TaylorAndonian/cycloidal-drive/designs/02-cyc50-d100/analysis/load_sharing_design.png

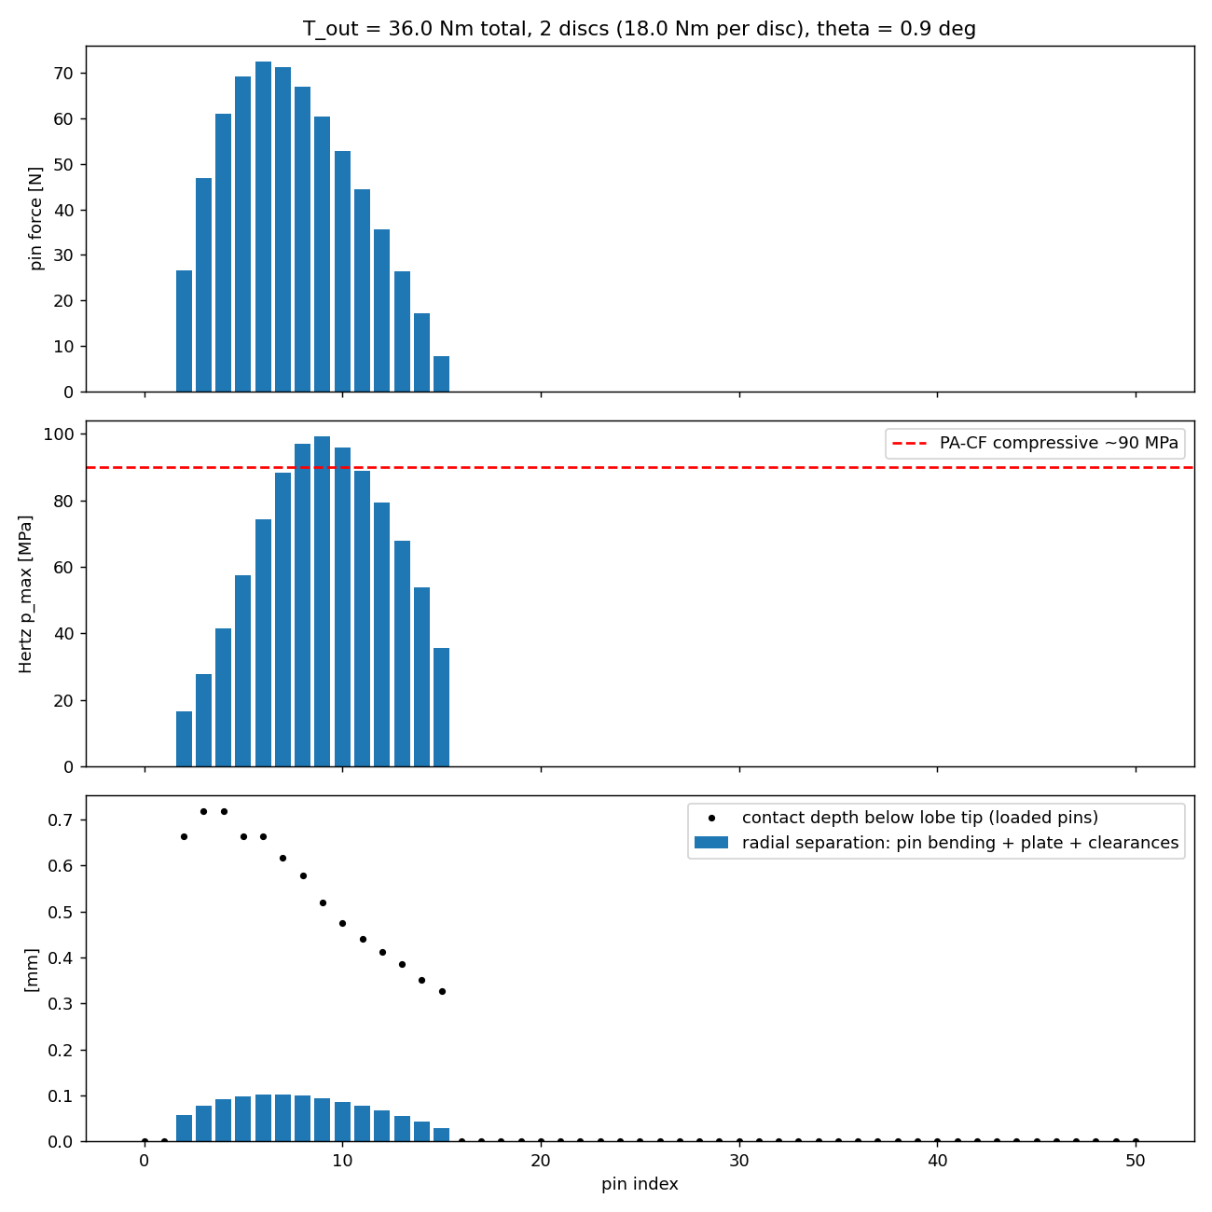
designs/02-cyc50-d100/analysis/load_sharing_design.png
