TaylorAndonian/cycloidal-drive/designs/02-cyc50-d100/analysis/margin_vs_torque.png

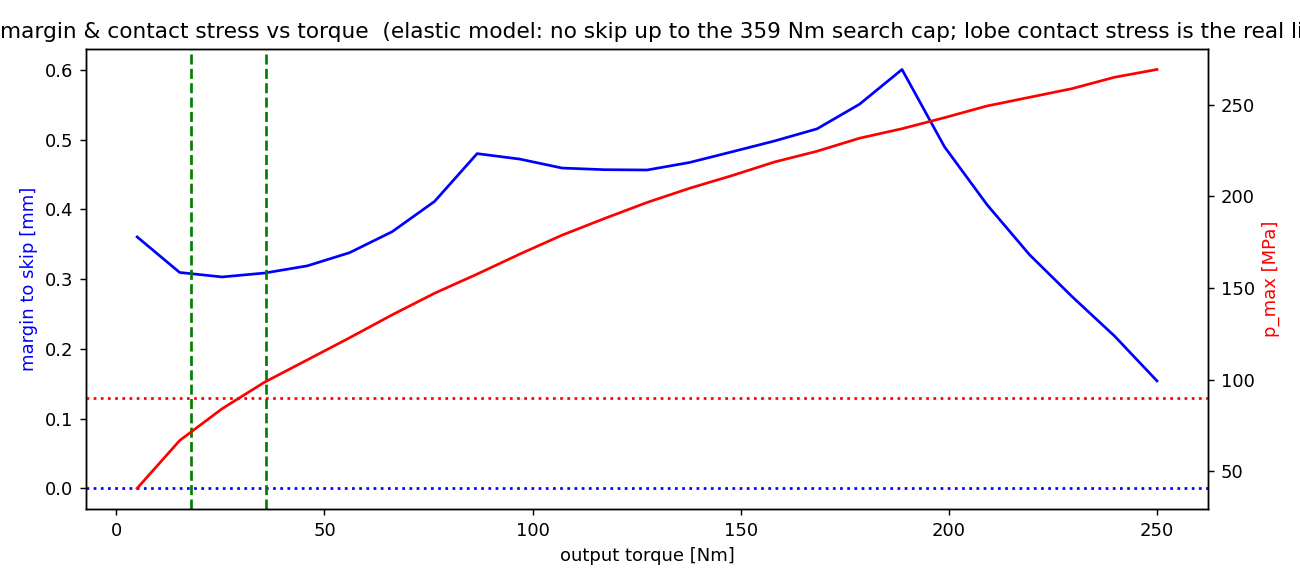
designs/02-cyc50-d100/analysis/margin_vs_torque.png
