TaylorAndonian/cycloidal-drive/designs/02-cyc50-d100/analysis/pressure_angle_pins.png

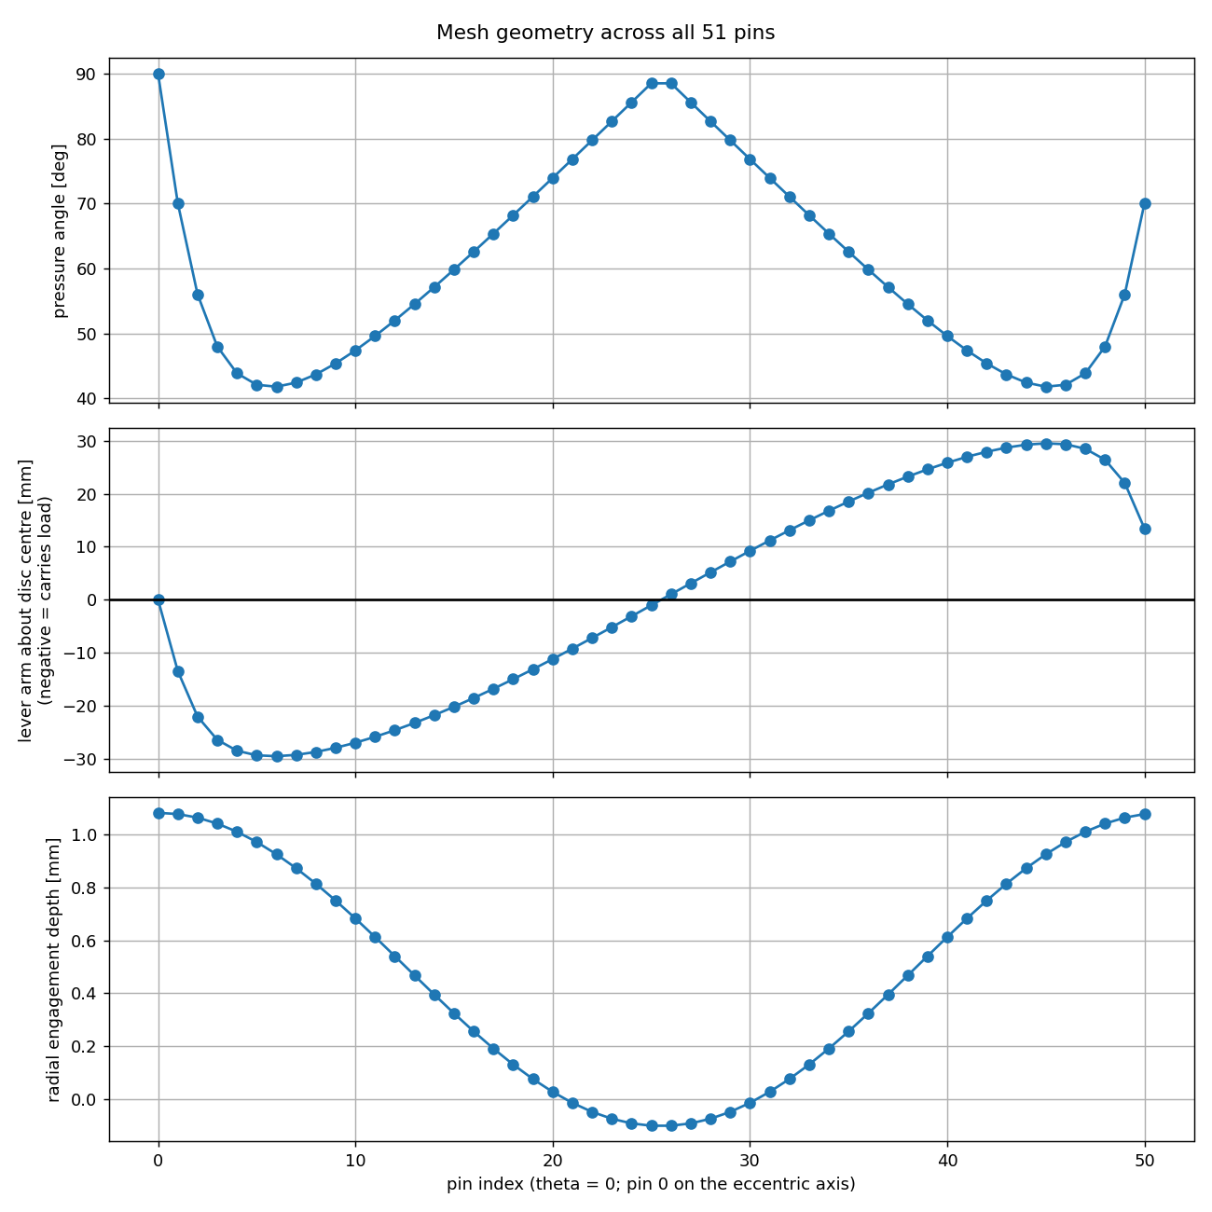
designs/02-cyc50-d100/analysis/pressure_angle_pins.png
