TaylorAndonian/cycloidal-drive/designs/02-cyc50-d100/analysis/profile.png

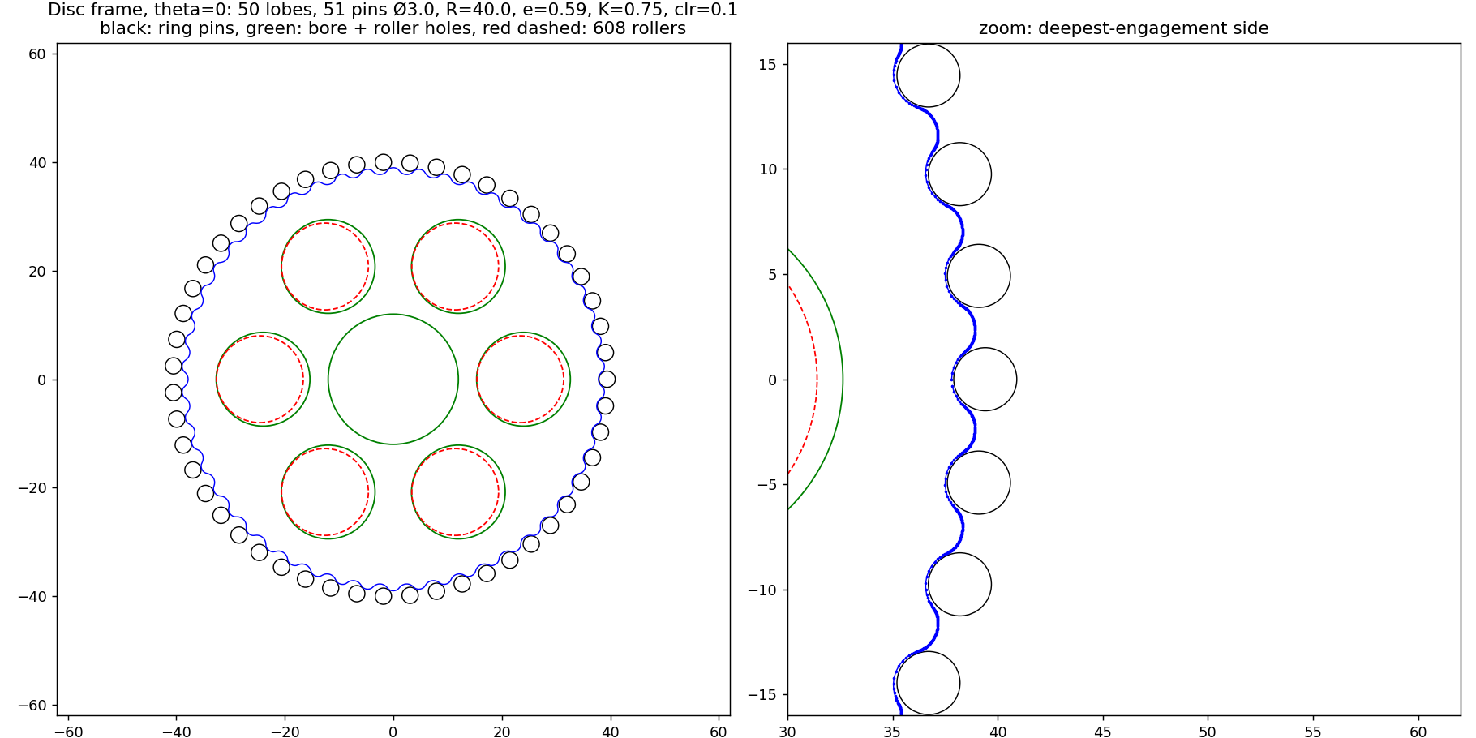
designs/02-cyc50-d100/analysis/profile.png
