TaylorAndonian/cycloidal-drive/designs/02-cyc50-d100/renders/axial_layout.png

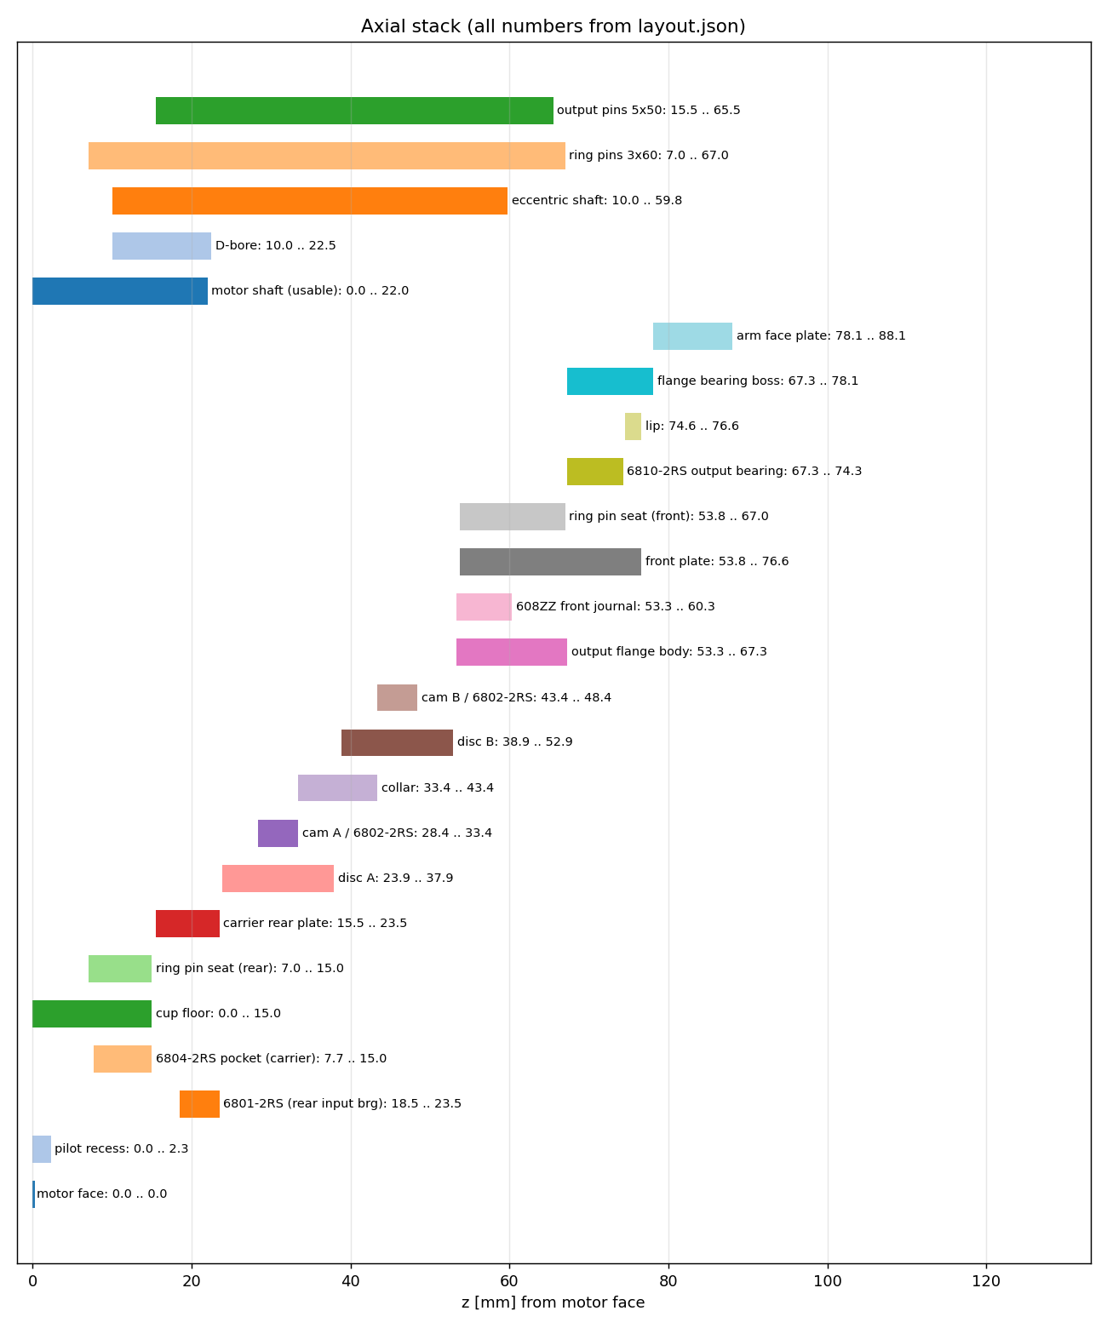
designs/02-cyc50-d100/renders/axial_layout.png
