TaylorAndonian/cycloidal-drive/designs/03-cyc30-d80-v1/preview.png

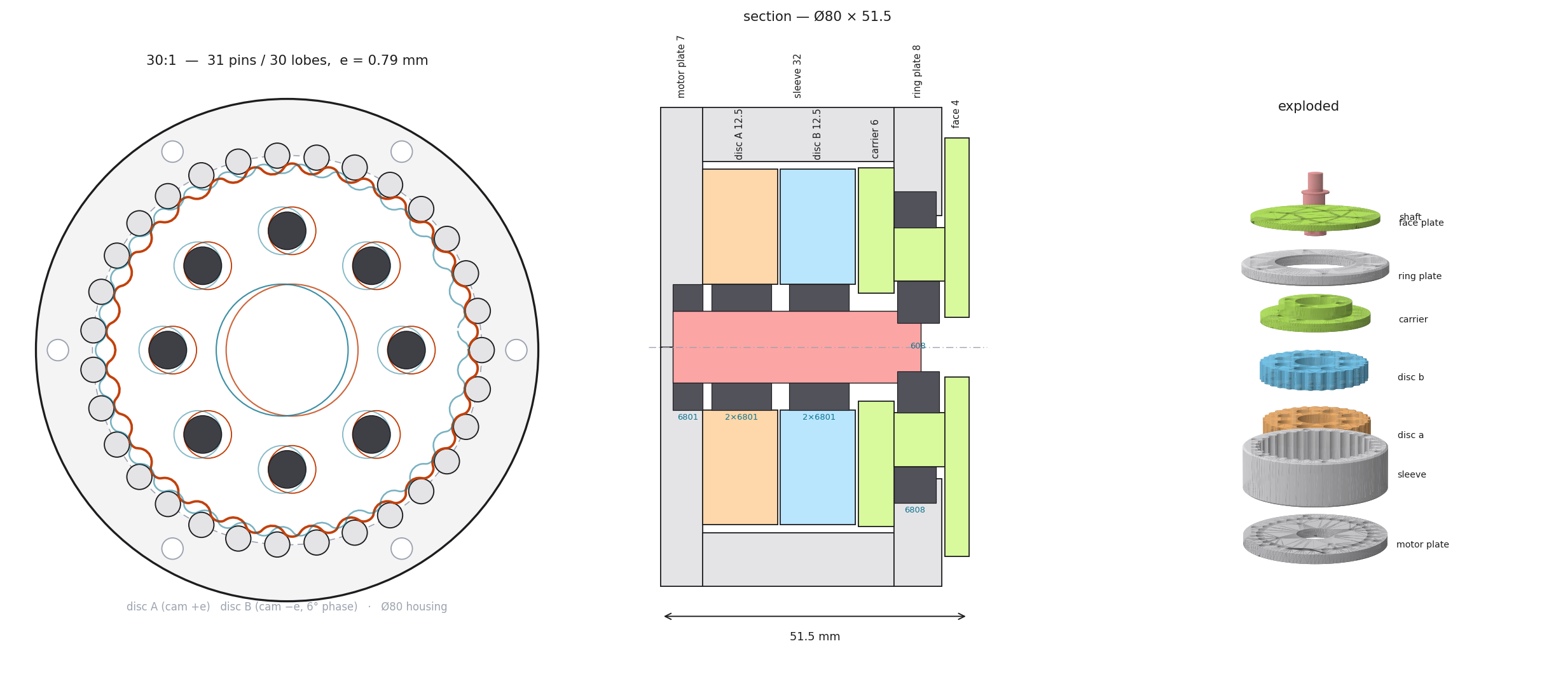
designs/03-cyc30-d80-v1/preview.png
