TaylorAndonian/cycloidal-drive/designs/06-cyc30-d80-belt/belt_iso.png

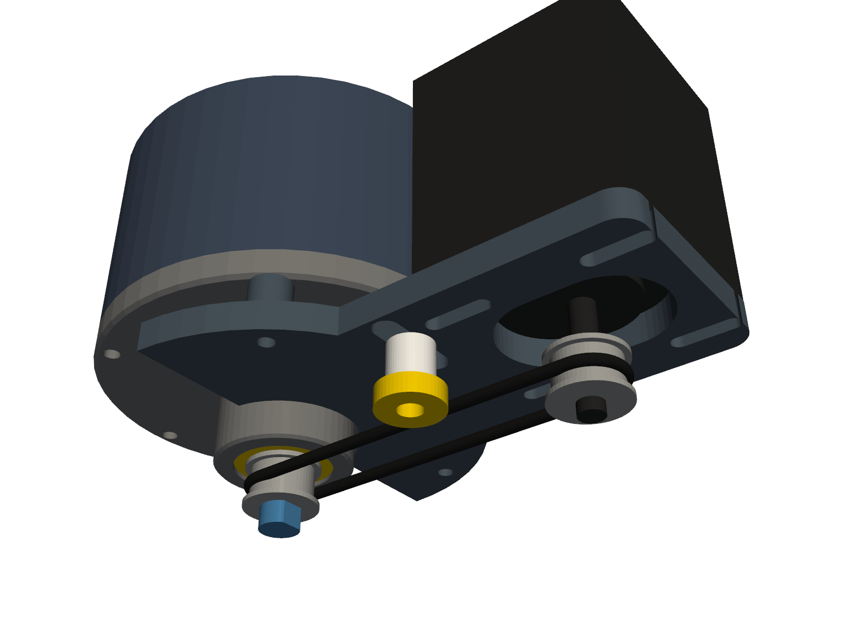
designs/06-cyc30-d80-belt/belt_iso.png
