TaylorAndonian/cycloidal-drive/designs/01-cyc50-d138/cad/assembly.step

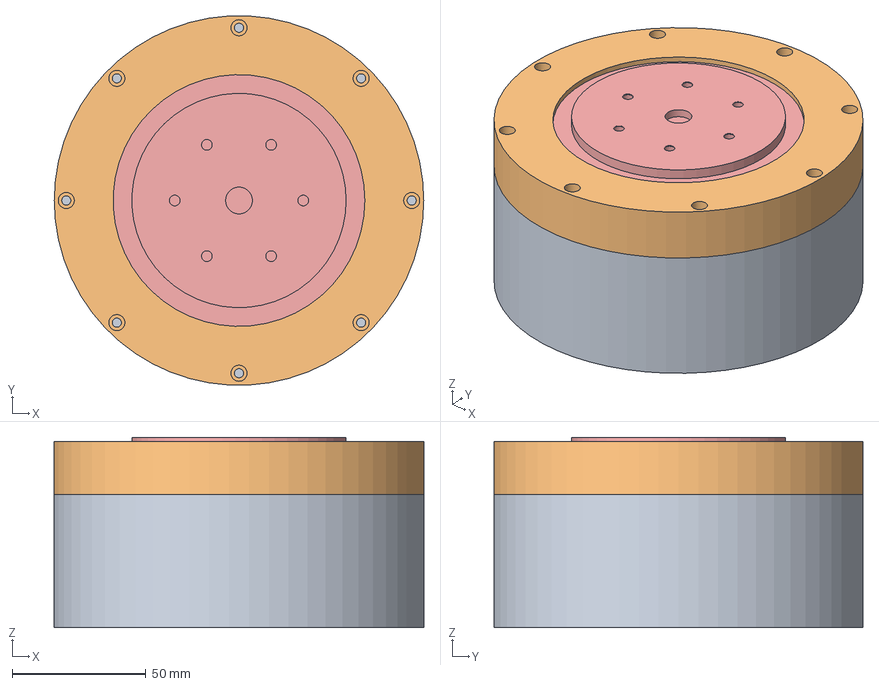
[picture p11: CAD file, 2026-09-05]
designs/01-cyc50-d138/cad/assembly.step
138.0 x 137.8 x 71.1 mm
