TaylorAndonian/cycloidal-drive/designs/03-cyc30-d80-v1/step/assembly.step

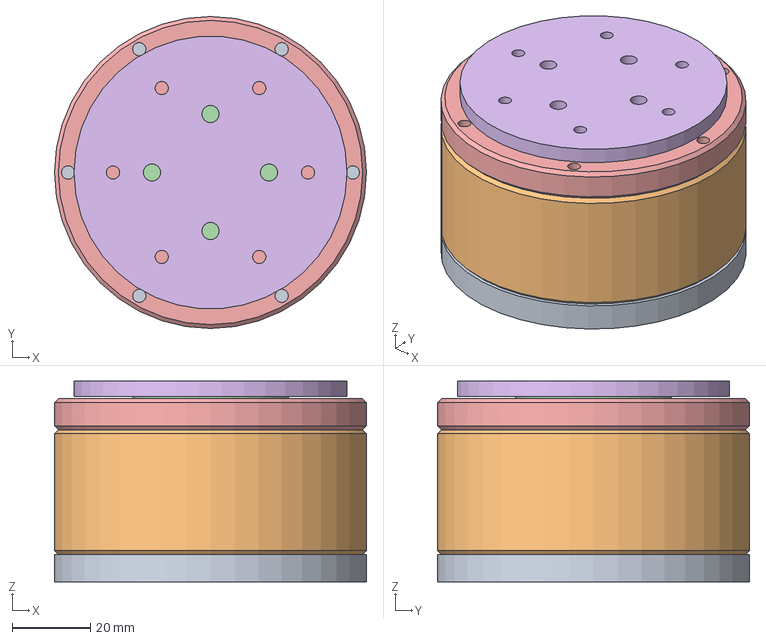
[picture p12: CAD file, 2026-09-16]
designs/03-cyc30-d80-v1/step/assembly.step
80.0 x 80.0 x 51.5 mm
