TaylorAndonian/cycloidal-drive/designs/06-cyc30-d80-belt/step/ASSEMBLY_belt_drive.step

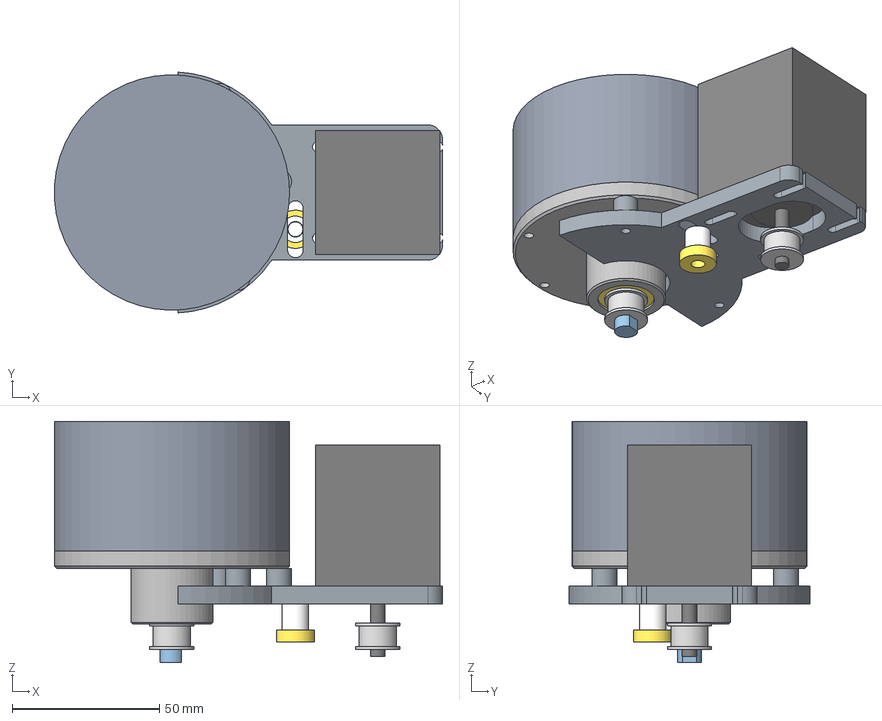
[picture p13: CAD file, 2026-10-05]
designs/06-cyc30-d80-belt/step/ASSEMBLY_belt_drive.step
131.9 x 81.9 x 82.0 mm
back_plate_belt
input_shaft
motor_bracket
idler_standoff
tower_bearing_spacer
608_rear_1
608_rear_2
pulley_20T_shaft
pulley_20T_motor
idler_F695
housing_reference
NEMA17
