TaylorAndonian/cycloidal-drive/designs/04-cyc30-d80-v2/step/ASSEMBLY_cycloidal_30_d80_v2.step

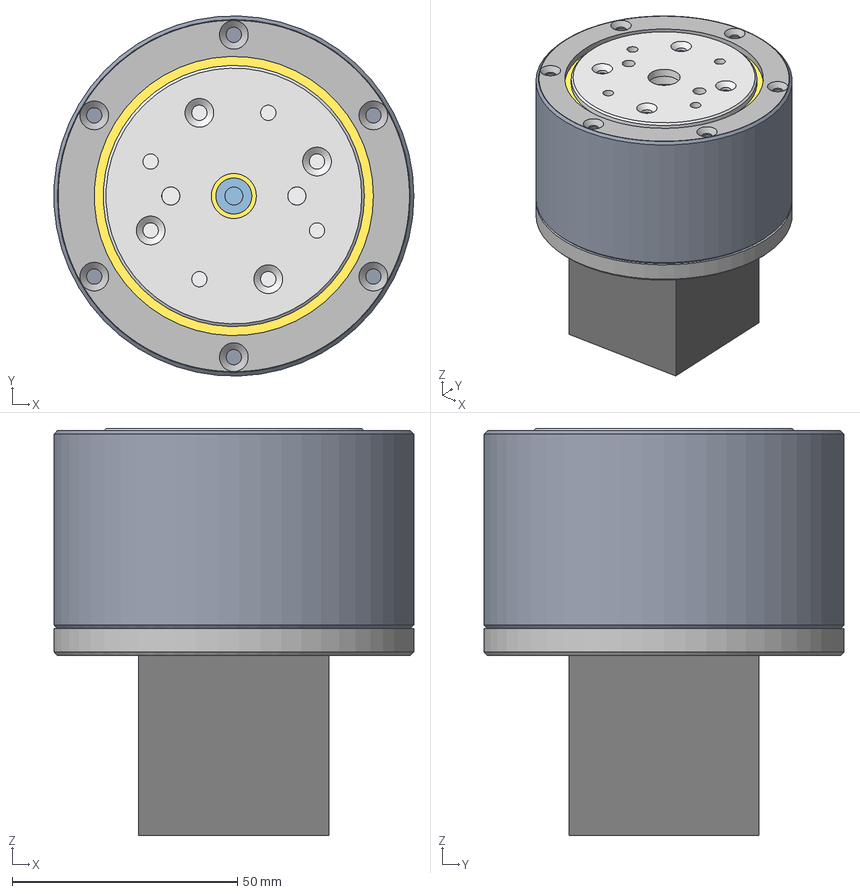
[picture p14: CAD file, 2026-09-22]
designs/04-cyc30-d80-v2/step/ASSEMBLY_cycloidal_30_d80_v2.step
79.9 x 80.0 x 90.5 mm
back_plate
housing
front_retainer
disc_2 (rotated 90deg) x 2
cam_B x 2
input_shaft
shaft_spacer
rear_ring
output_flange
output_cap
ring_pin_0
ring_pin_1
ring_pin_2
ring_pin_3
ring_pin_4
ring_pin_5
ring_pin_6
ring_pin_7
ring_pin_8
ring_pin_9
ring_pin_10
ring_pin_11
ring_pin_12
ring_pin_13
ring_pin_14
ring_pin_15
ring_pin_16
ring_pin_17
ring_pin_18
ring_pin_19
ring_pin_20
ring_pin_21
ring_pin_22
ring_pin_23
ring_pin_24
ring_pin_25
ring_pin_26
ring_pin_27
ring_pin_28
ring_pin_29
ring_pin_30
shoulder_bolt_0
MR105_0 x 2
sleeve x 24
shoulder_bolt_1
MR105_1 x 2
shoulder_bolt_2
MR105_2 x 2
shoulder_bolt_3
MR105_3 x 2
shoulder_bolt_4
MR105_4 x 2
shoulder_bolt_5
MR105_5 x 2
shoulder_bolt_6
MR105_6 x 2
shoulder_bolt_7
MR105_7 x 2
6803_disc1 x 2
6803_disc2 x 2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
