TaylorAndonian/cycloidal-drive/designs/02-cyc50-d100/cad/assembly.step

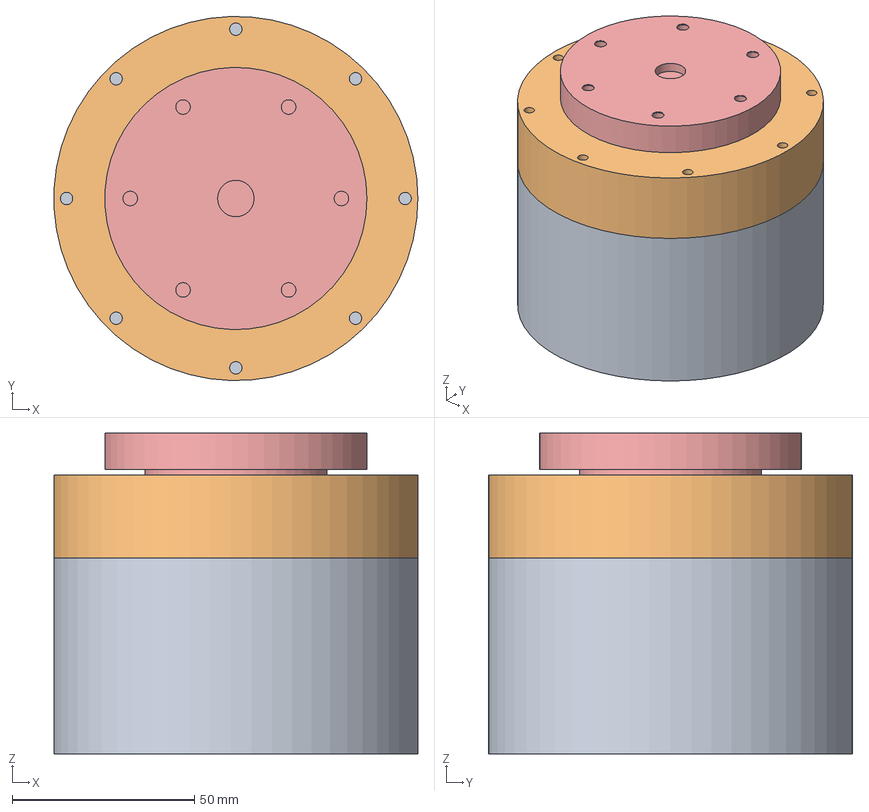
[picture p15: CAD file, 2026-09-05]
designs/02-cyc50-d100/cad/assembly.step
99.9 x 100.0 x 88.1 mm
