TaylorAndonian/cycloidal-drive/designs/02-cyc50-d100/cad/eccentric_shaft.step

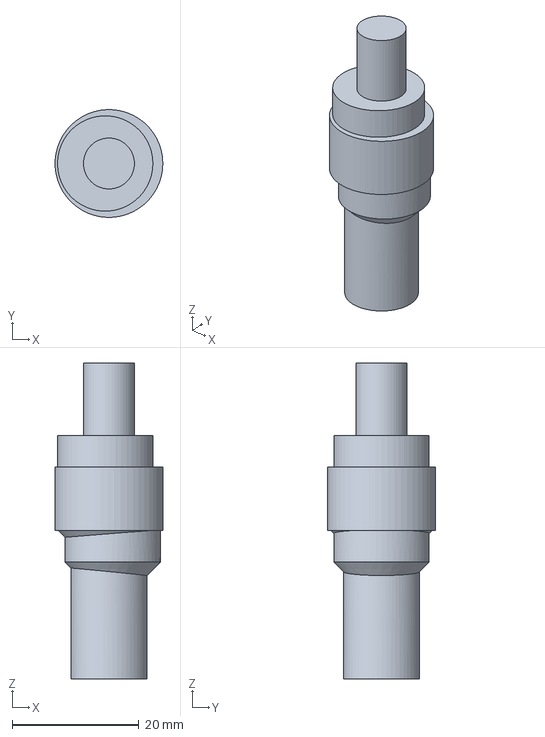
[picture p16: CAD file, 2026-09-10]
designs/02-cyc50-d100/cad/eccentric_shaft.step
17.0 x 17.0 x 49.8 mm
