TaylorAndonian/cycloidal-drive/designs/03-cyc30-d80-v1/step/disc_b.step

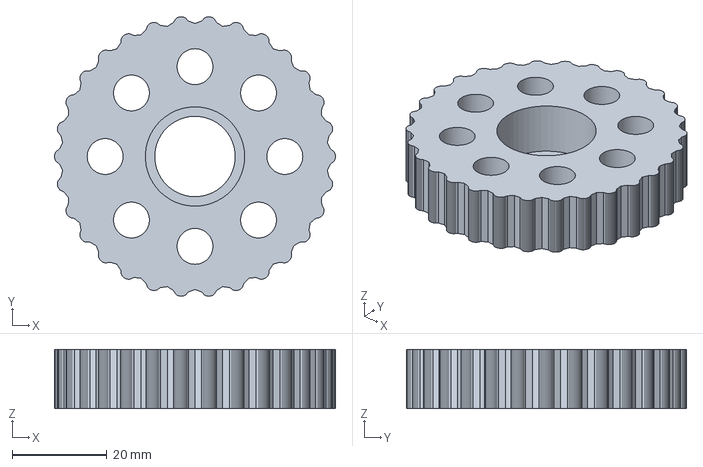
[picture p17: CAD file, 2026-09-16]
designs/03-cyc30-d80-v1/step/disc_b.step
59.4 x 59.1 x 12.5 mm
