TaylorAndonian/cycloidal-drive/designs/04-cyc30-d80-v2/step/back_plate.step

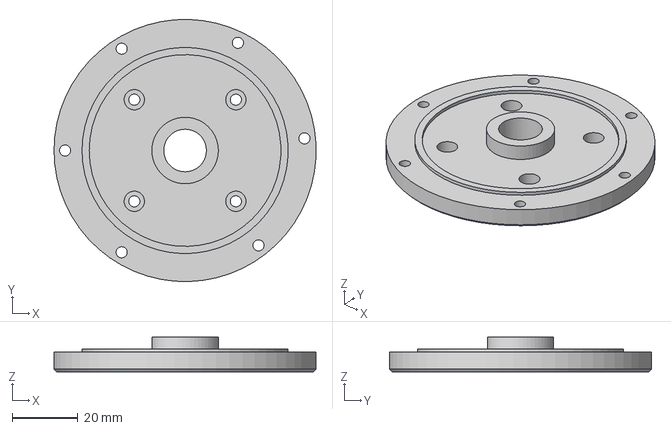
[picture p18: CAD file, 2026-09-30]
designs/04-cyc30-d80-v2/step/back_plate.step
79.9 x 80.0 x 10.6 mm
