TaylorAndonian/cycloidal-drive/designs/05-cyc30-d80-v3/step/housing.step

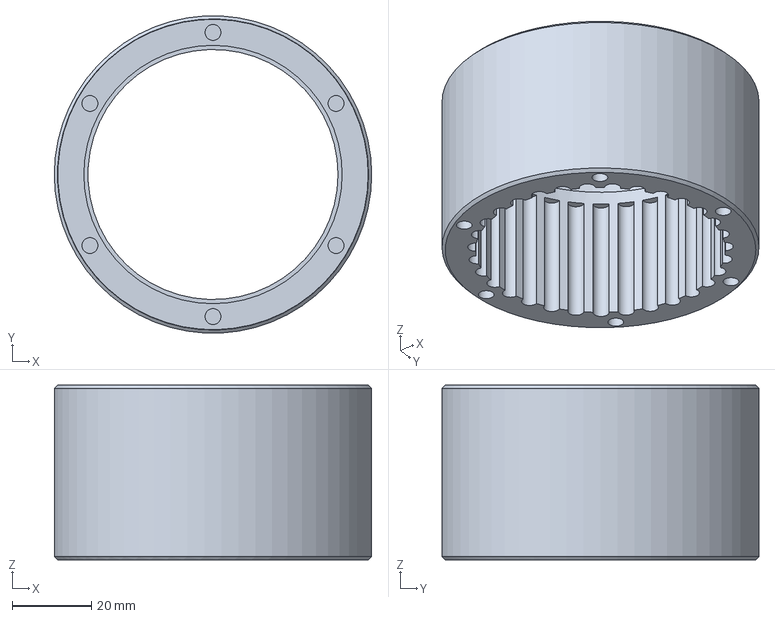
[picture p19: CAD file, 2026-10-02]
designs/05-cyc30-d80-v3/step/housing.step
80.0 x 79.9 x 44.0 mm
