TaylorAndonian/cycloidal-drive/designs/06-cyc30-d80-belt/step/back_plate_belt.step

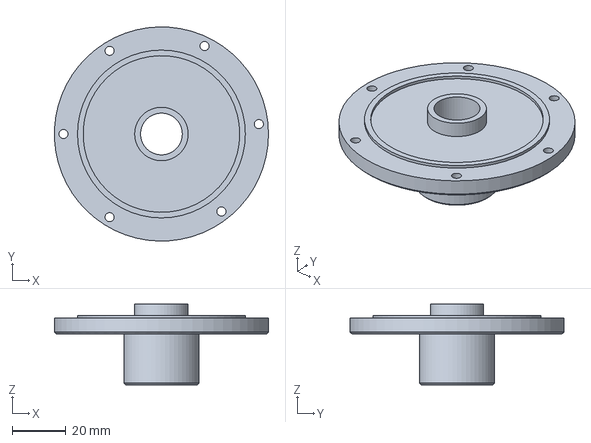
[picture p20: CAD file, 2026-10-05]
designs/06-cyc30-d80-belt/step/back_plate_belt.step
79.9 x 80.0 x 30.1 mm
