TaylorAndonian/cycloidal-drive/designs/02-cyc50-d100/cad/coupon_shaft.step

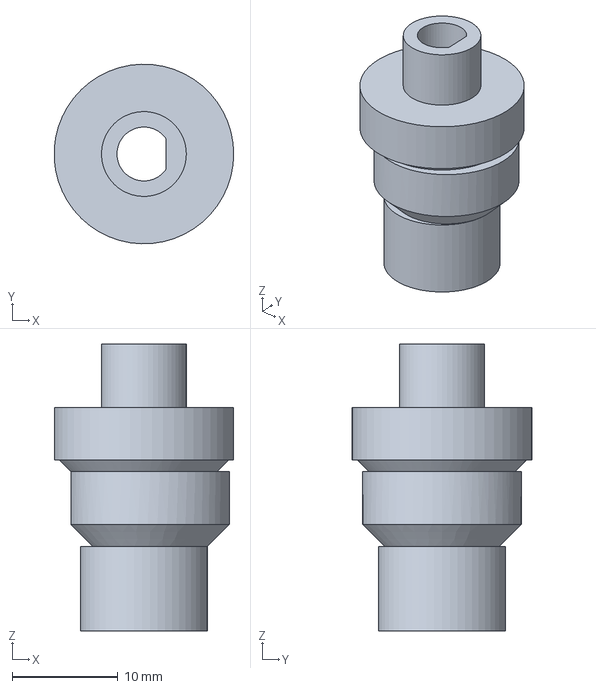
[picture p21: CAD file, 2026-09-10]
designs/02-cyc50-d100/cad/coupon_shaft.step
17.0 x 17.0 x 27.2 mm
