TaylorAndonian/cycloidal-drive/designs/03-cyc30-d80-v1/step/ring_plate.step

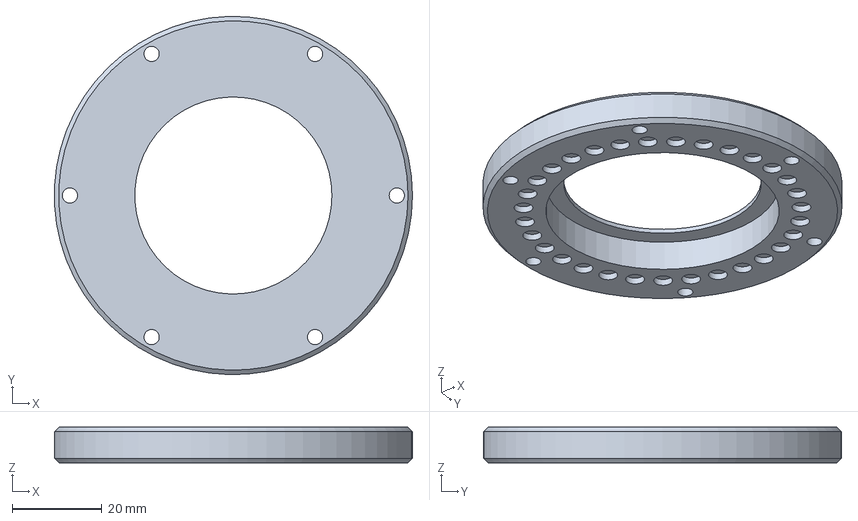
[picture p22: CAD file, 2026-09-16]
designs/03-cyc30-d80-v1/step/ring_plate.step
79.9 x 80.0 x 8.00 mm
