TaylorAndonian/cycloidal-drive/designs/04-cyc30-d80-v2/step/cam.step

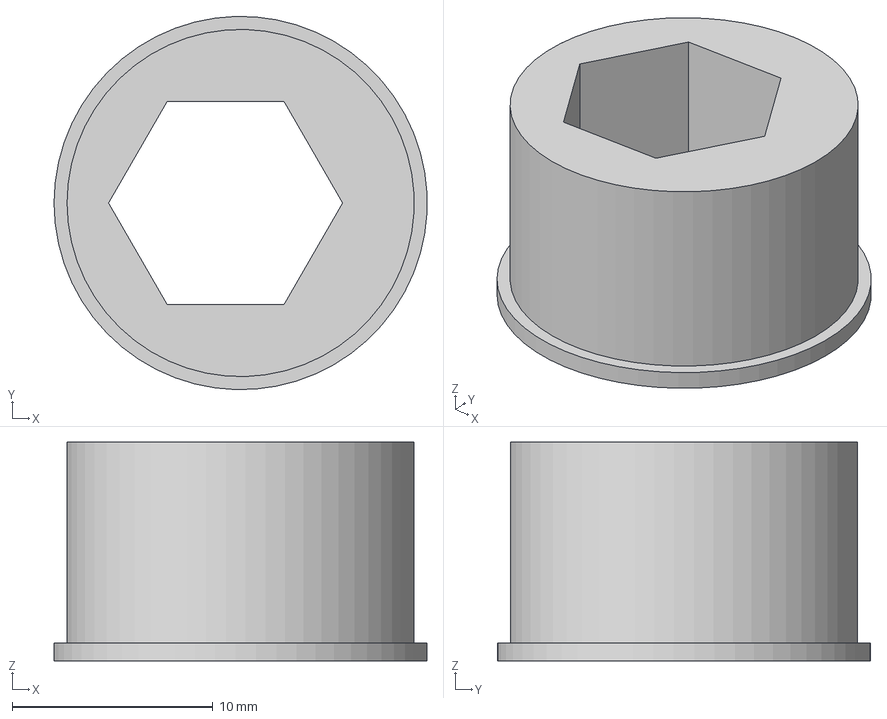
[picture p23: CAD file, 2026-09-29]
designs/04-cyc30-d80-v2/step/cam.step
18.6 x 18.6 x 10.9 mm
