TaylorAndonian/cycloidal-drive/designs/05-cyc30-d80-v3/step/fit_coupon.step

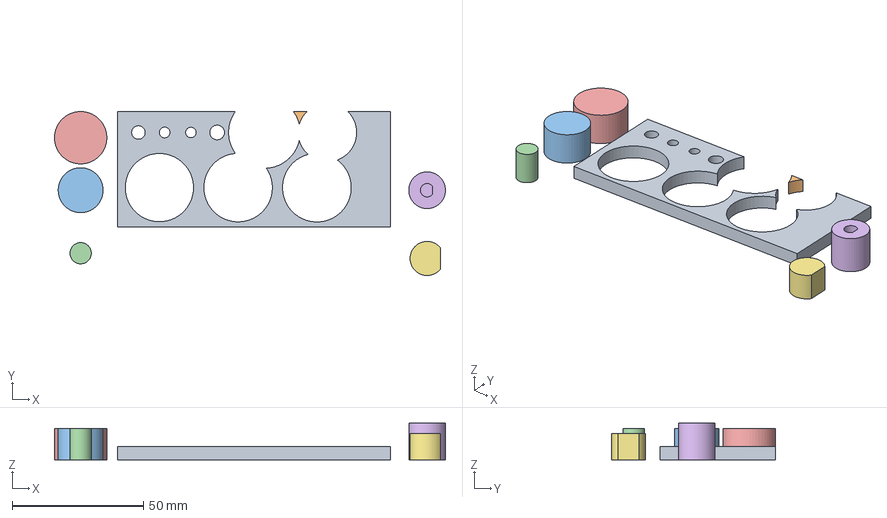
[picture p24: CAD file, 2026-10-02]
designs/05-cyc30-d80-v3/step/fit_coupon.step
149.0 x 62.5 x 14.0 mm
