TaylorAndonian/cycloidal-drive/designs/06-cyc30-d80-belt/step/idler_standoff.step

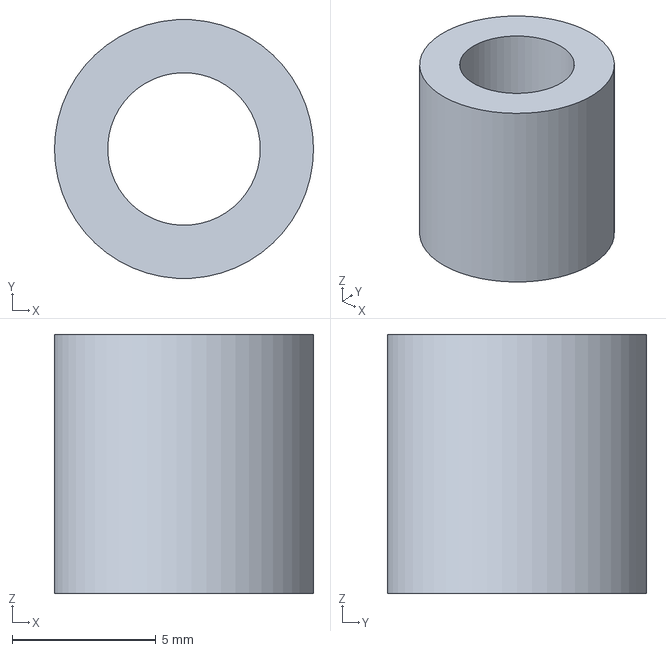
[picture p25: CAD file, 2026-10-05]
designs/06-cyc30-d80-belt/step/idler_standoff.step
9.00 x 8.98 x 9.00 mm
