TaylorAndonian/cycloidal-drive/designs/02-cyc50-d100/cad/disc v1.step

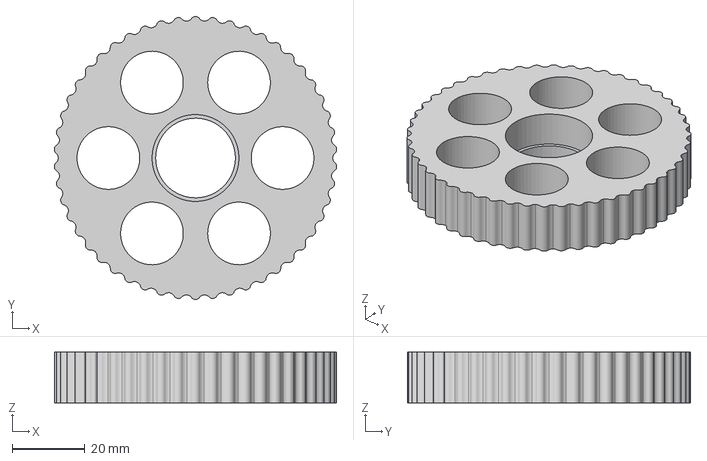
[picture p26: CAD file, 2026-09-08]
designs/02-cyc50-d100/cad/disc v1.step
77.8 x 78.0 x 14.0 mm
