TaylorAndonian/cycloidal-drive/designs/04-cyc30-d80-v2/step/input_shaft.step

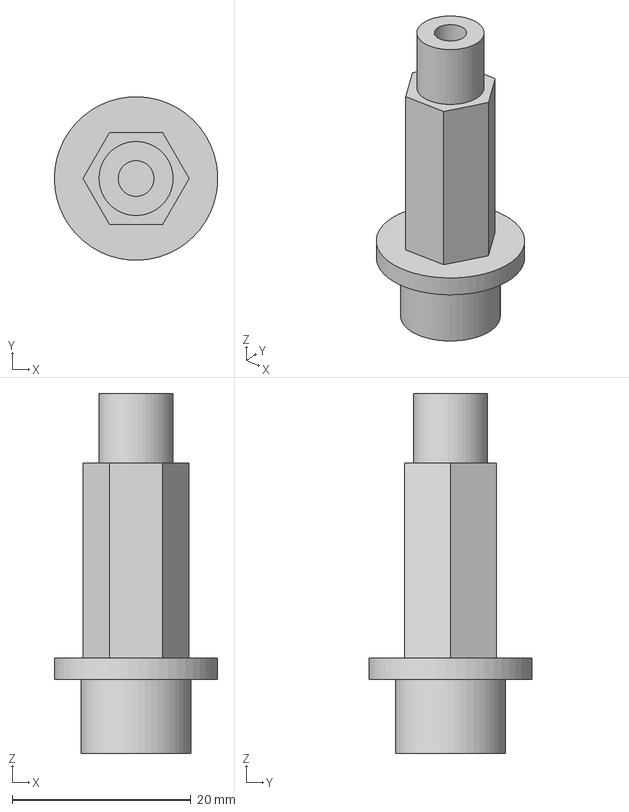
[picture p27: CAD file, 2026-09-26]
designs/04-cyc30-d80-v2/step/input_shaft.step
18.3 x 18.3 x 40.3 mm
