TaylorAndonian/cycloidal-drive/designs/05-cyc30-d80-v3/step/rear_ring.step

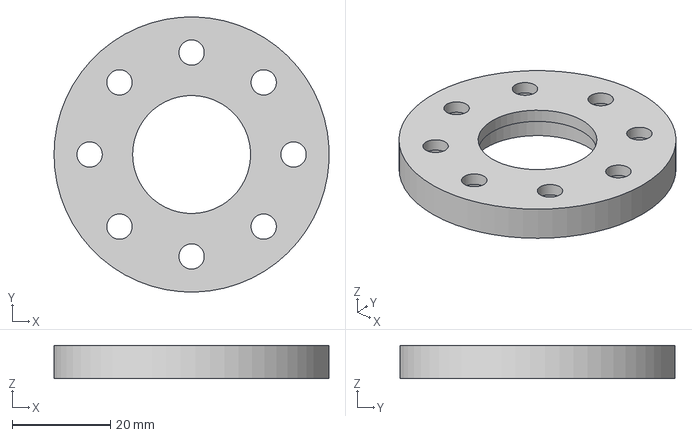
[picture p28: CAD file, 2026-10-02]
designs/05-cyc30-d80-v3/step/rear_ring.step
56.0 x 56.0 x 6.80 mm
