TaylorAndonian/cycloidal-drive/designs/02-cyc50-d100/cad/mid_pin_ring.step

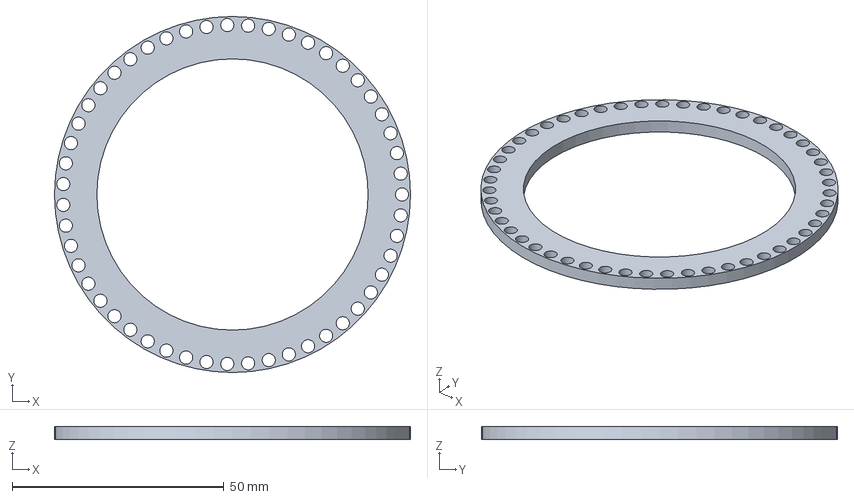
[picture p29: CAD file, 2026-09-05]
designs/02-cyc50-d100/cad/mid_pin_ring.step
84.0 x 84.0 x 3.00 mm
