TaylorAndonian/cycloidal-drive/designs/03-cyc30-d80-v1/step/shaft.step

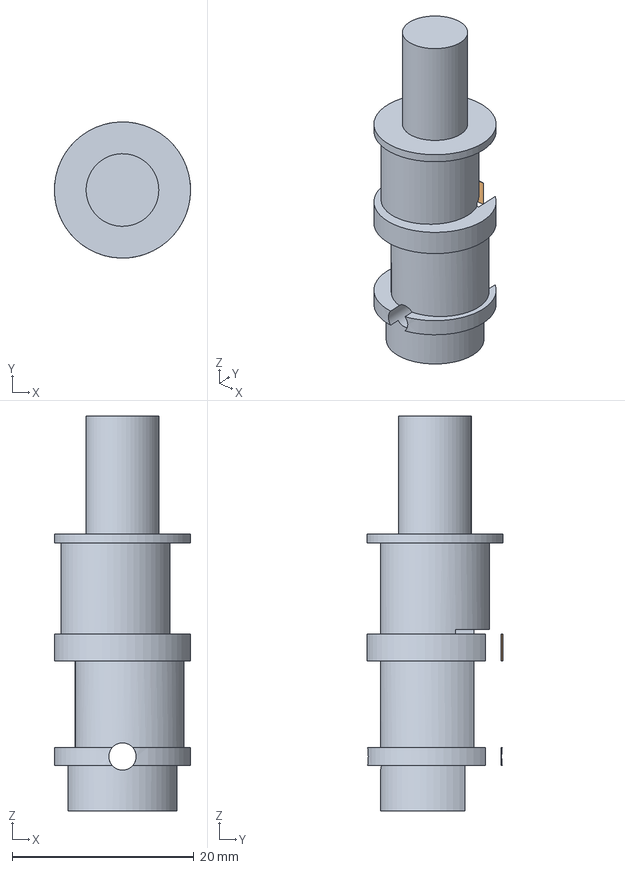
[picture p30: CAD file, 2026-09-16]
designs/03-cyc30-d80-v1/step/shaft.step
15.0 x 15.0 x 43.5 mm
