TaylorAndonian/cycloidal-drive/designs/04-cyc30-d80-v2/step/C DISK.step

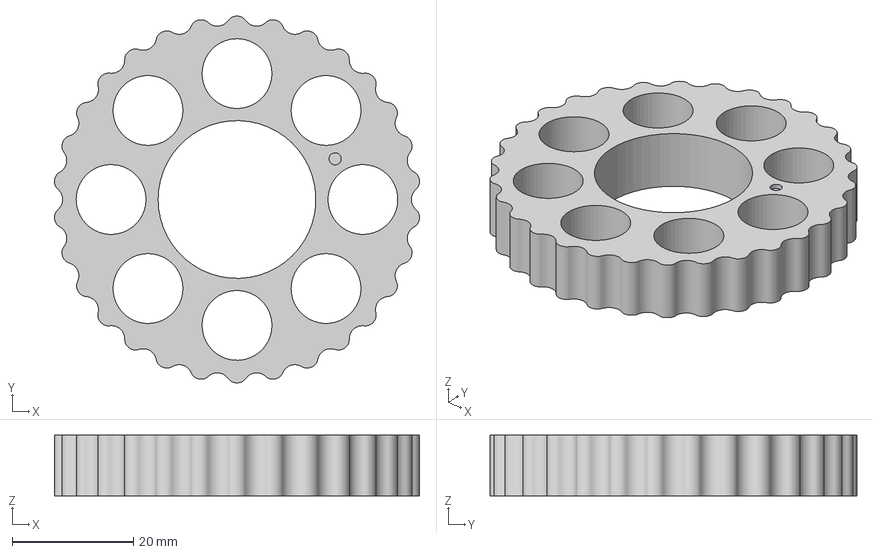
[picture p31: CAD file, 2026-09-23]
designs/04-cyc30-d80-v2/step/C DISK.step
60.1 x 60.5 x 10.0 mm
