TaylorAndonian/cycloidal-drive/designs/05-cyc30-d80-v3/step/output_flange.step

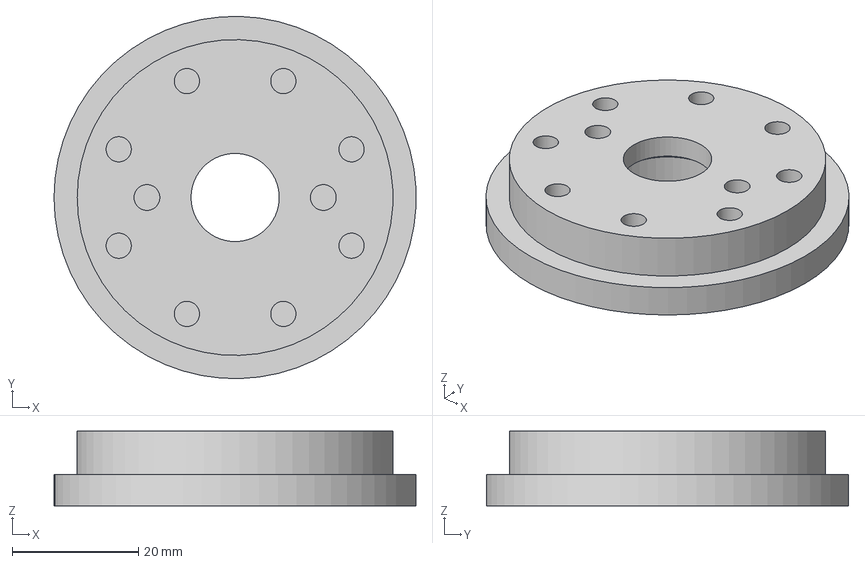
[picture p32: CAD file, 2026-10-02]
designs/05-cyc30-d80-v3/step/output_flange.step
57.5 x 57.5 x 11.9 mm
