TaylorAndonian/cycloidal-drive/designs/06-cyc30-d80-belt/step/tower_bearing_spacer.step

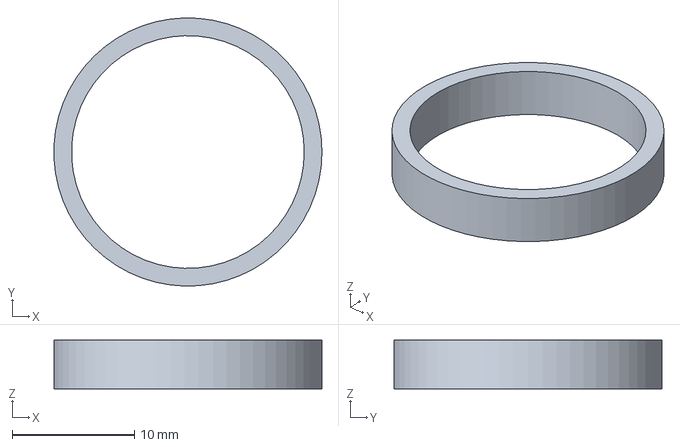
[picture p33: CAD file, 2026-10-05]
designs/06-cyc30-d80-belt/step/tower_bearing_spacer.step
21.9 x 21.9 x 4.00 mm
