TaylorAndonian/cycloidal-drive/designs/02-cyc50-d100/cad/front_plate.step

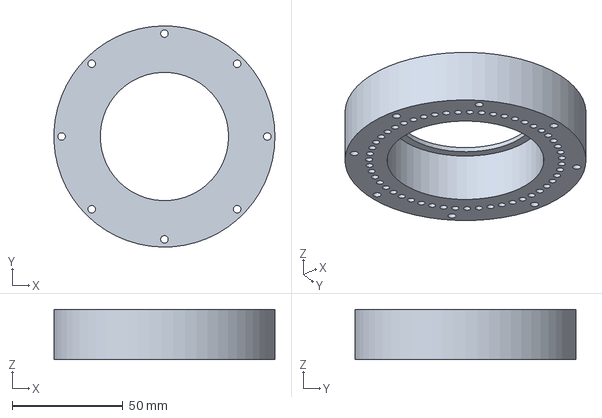
[picture p34: CAD file, 2026-09-05]
designs/02-cyc50-d100/cad/front_plate.step
99.9 x 100.0 x 22.8 mm
