TaylorAndonian/cycloidal-drive/designs/03-cyc30-d80-v1/step/coupon.step

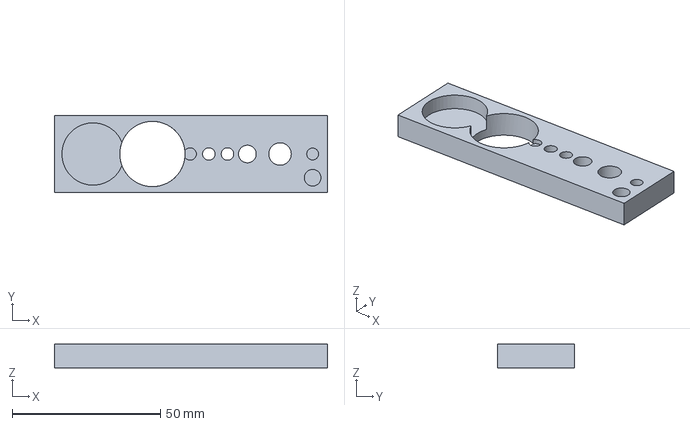
[picture p35: CAD file, 2026-09-16]
designs/03-cyc30-d80-v1/step/coupon.step
92.0 x 26.0 x 8.00 mm
