TaylorAndonian/cycloidal-drive/designs/05-cyc30-d80-v3/step/roller_sleeve_3.6.step

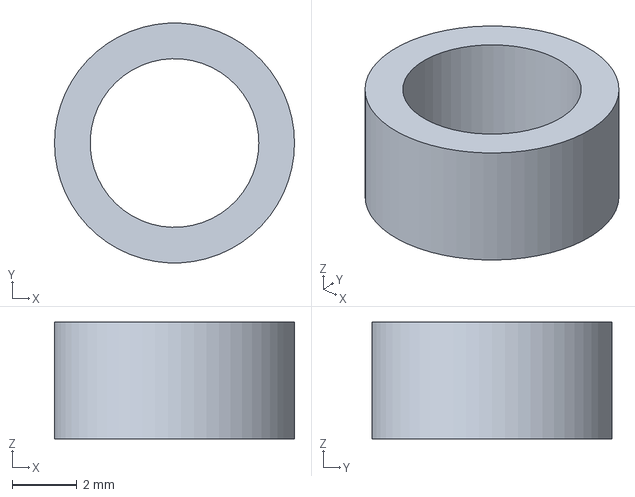
[picture p36: CAD file, 2026-10-01]
designs/05-cyc30-d80-v3/step/roller_sleeve_3.6.step
7.40 x 7.39 x 3.60 mm
