TaylorAndonian/cycloidal-drive/designs/06-cyc30-d80-belt/step/motor_bracket.step

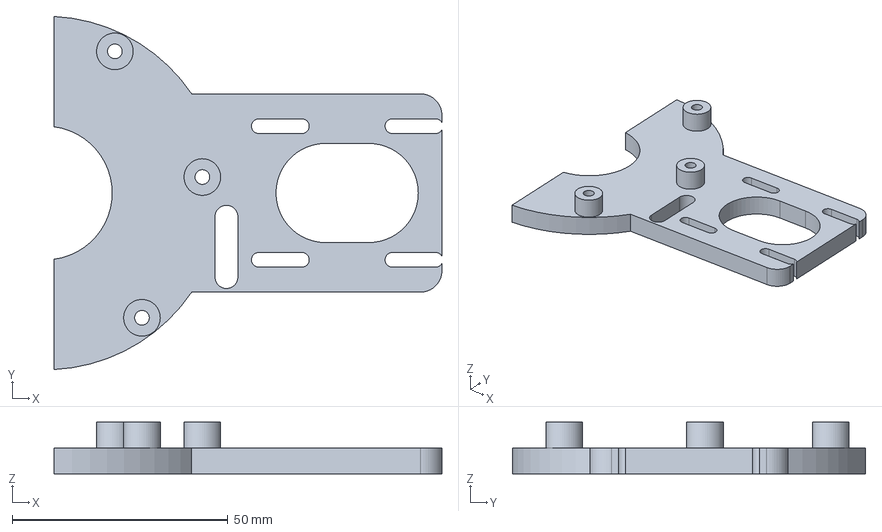
[picture p37: CAD file, 2026-10-05]
designs/06-cyc30-d80-belt/step/motor_bracket.step
90.0 x 81.9 x 12.0 mm
