TaylorAndonian/cycloidal-drive/designs/03-cyc30-d80-v1/step/sleeve.step

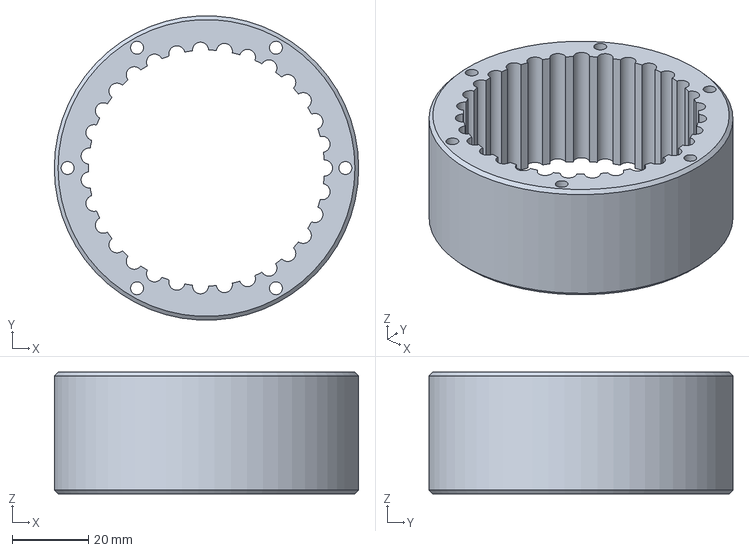
[picture p38: CAD file, 2026-09-16]
designs/03-cyc30-d80-v1/step/sleeve.step
80.0 x 79.9 x 32.0 mm
