TaylorAndonian/cycloidal-drive/designs/04-cyc30-d80-v2/step/roller_sleeve_6p9.step

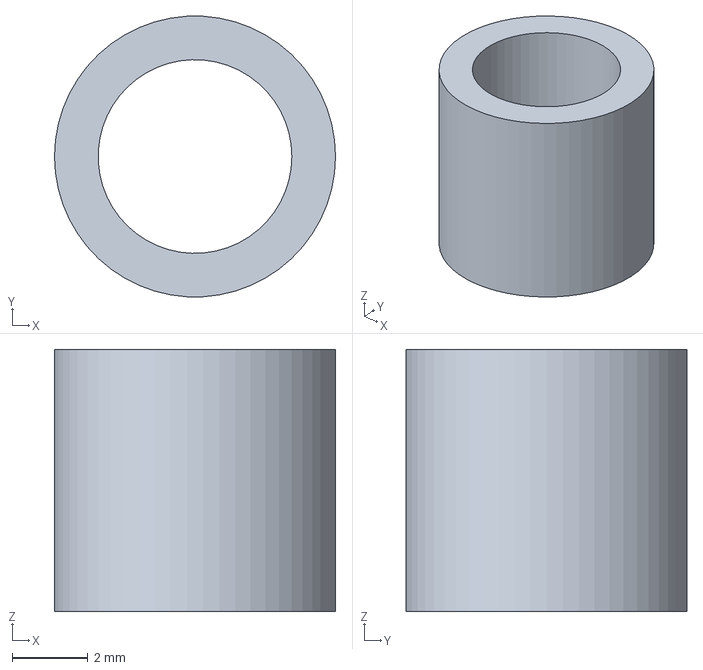
[picture p39: CAD file, 2026-09-22]
designs/04-cyc30-d80-v2/step/roller_sleeve_6p9.step
7.40 x 7.39 x 6.90 mm
