TaylorAndonian/cycloidal-drive/designs/05-cyc30-d80-v3/step/input_shaft.step

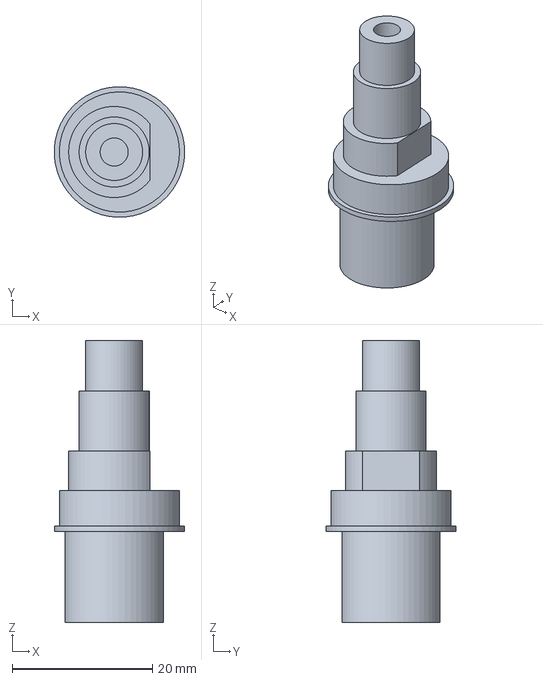
[picture p40: CAD file, 2026-10-01]
designs/05-cyc30-d80-v3/step/input_shaft.step
18.6 x 18.6 x 40.2 mm
