TaylorAndonian/cycloidal-drive/designs/06-cyc30-d80-belt/step/input_shaft_belt.step

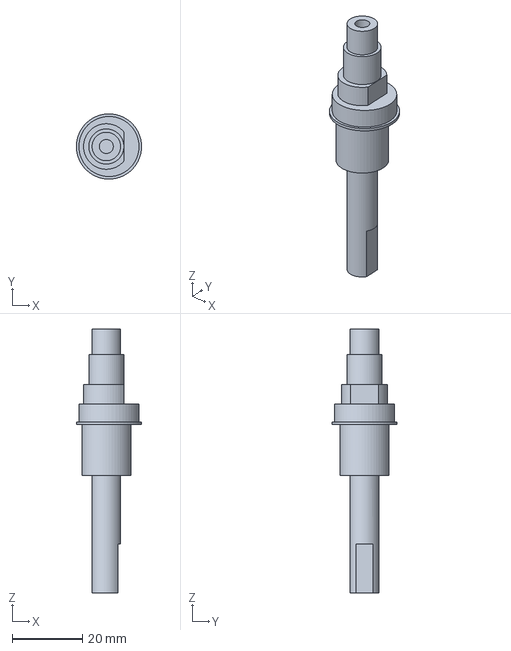
[picture p41: CAD file, 2026-10-05]
designs/06-cyc30-d80-belt/step/input_shaft_belt.step
18.6 x 18.6 x 75.2 mm
