TaylorAndonian/cycloidal-drive/designs/02-cyc50-d100/cad/coupon_bearings.step

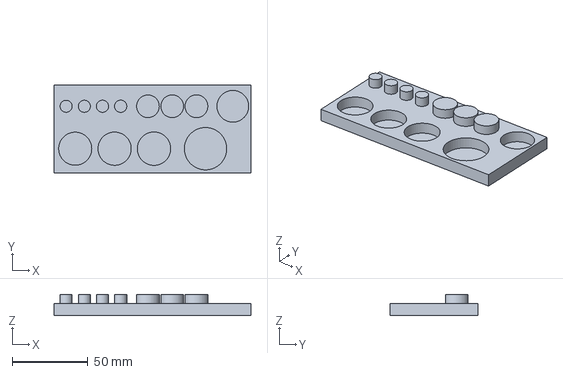
[picture p42: CAD file, 2026-09-05]
designs/02-cyc50-d100/cad/coupon_bearings.step
130.0 x 58.0 x 14.0 mm
