TaylorAndonian/cycloidal-drive/designs/03-cyc30-d80-v1/step/face_plate.step

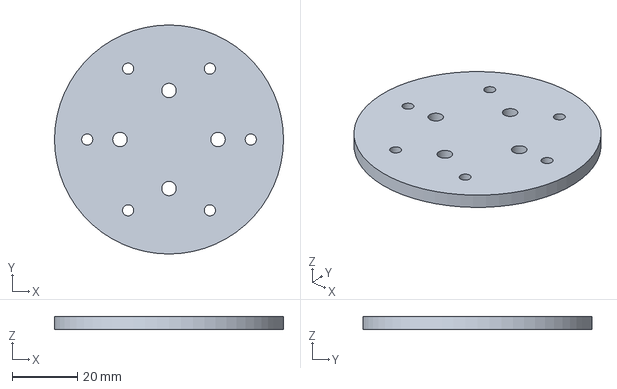
[picture p43: CAD file, 2026-09-16]
designs/03-cyc30-d80-v1/step/face_plate.step
70.0 x 70.0 x 4.00 mm
