TaylorAndonian/cycloidal-drive/designs/04-cyc30-d80-v2/step/roller_sleeve_3p9.step

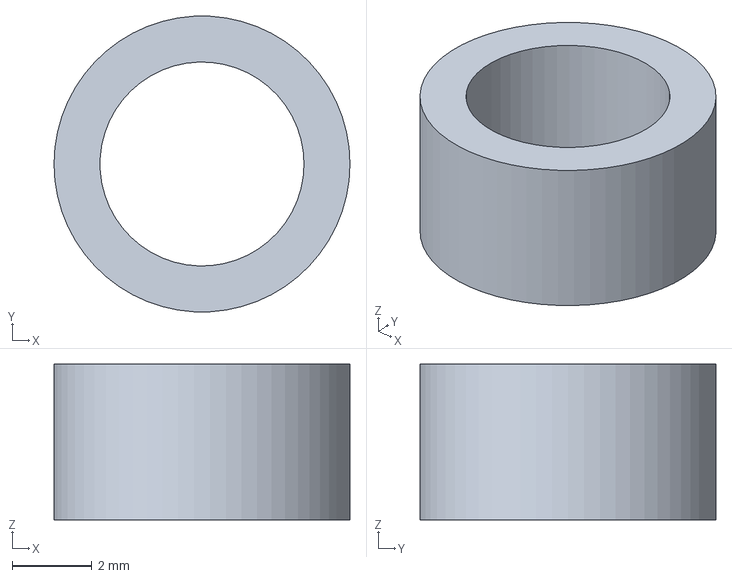
[picture p44: CAD file, 2026-09-22]
designs/04-cyc30-d80-v2/step/roller_sleeve_3p9.step
7.40 x 7.39 x 3.90 mm
