TaylorAndonian/cycloidal-drive/designs/05-cyc30-d80-v3/step/shaft_spacer.step

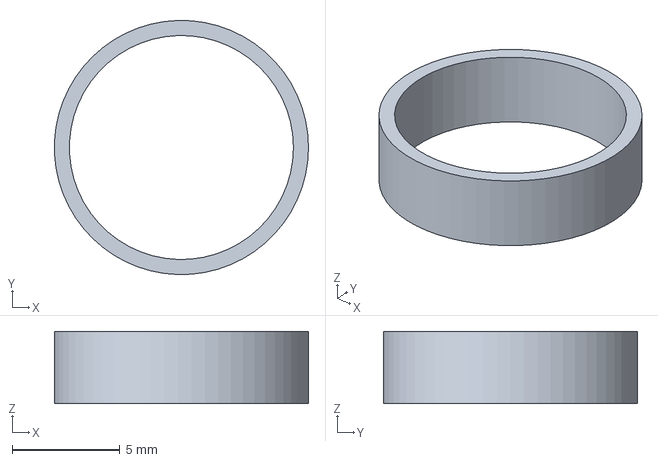
[picture p45: CAD file, 2026-10-01]
designs/05-cyc30-d80-v3/step/shaft_spacer.step
11.8 x 11.8 x 3.35 mm
