TaylorAndonian/cycloidal-drive/designs/04-cyc30-d80-v2/step/rear_ring.step

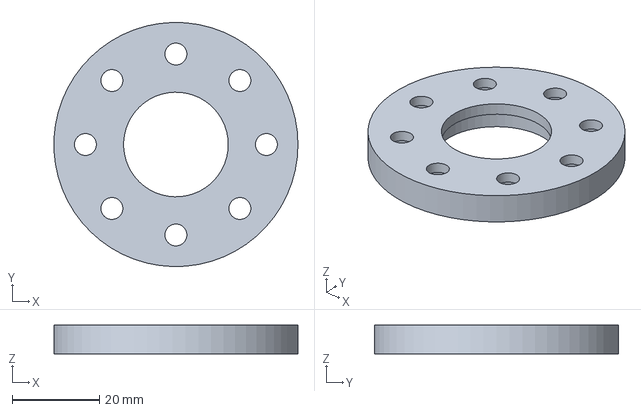
[picture p46: CAD file, 2026-09-22]
designs/04-cyc30-d80-v2/step/rear_ring.step
56.0 x 56.0 x 6.60 mm
