TaylorAndonian/cycloidal-drive/designs/05-cyc30-d80-v3/step/roller_sleeve_6.5.step

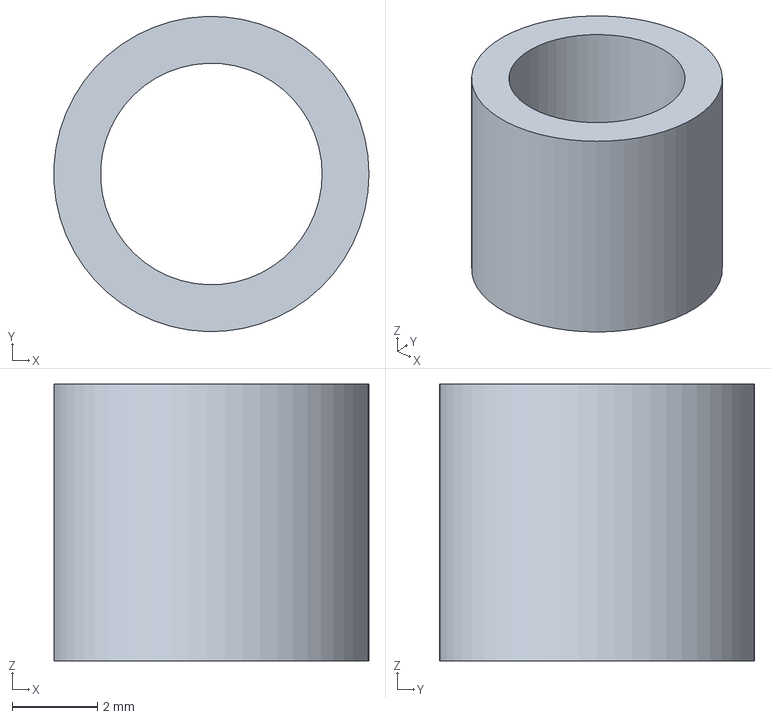
[picture p47: CAD file, 2026-10-01]
designs/05-cyc30-d80-v3/step/roller_sleeve_6.5.step
7.39 x 7.40 x 6.50 mm
