TaylorAndonian/cycloidal-drive/designs/02-cyc50-d100/cad/coupon_pins_inserts.step

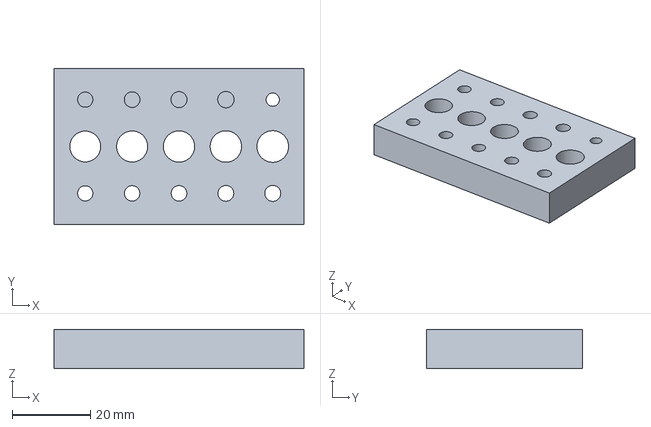
[picture p48: CAD file, 2026-09-05]
designs/02-cyc50-d100/cad/coupon_pins_inserts.step
64.0 x 40.0 x 10.0 mm
