TaylorAndonian/cycloidal-drive/designs/03-cyc30-d80-v1/step/motor_plate.step

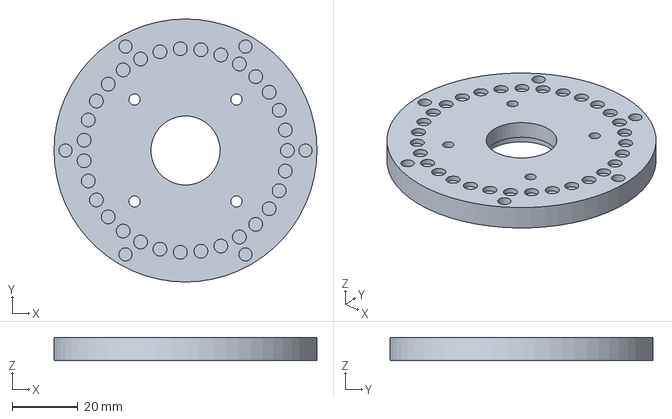
[picture p49: CAD file, 2026-09-16]
designs/03-cyc30-d80-v1/step/motor_plate.step
80.0 x 80.0 x 7.00 mm
