TaylorAndonian/cycloidal-drive/designs/04-cyc30-d80-v2/step/fit_coupon.step

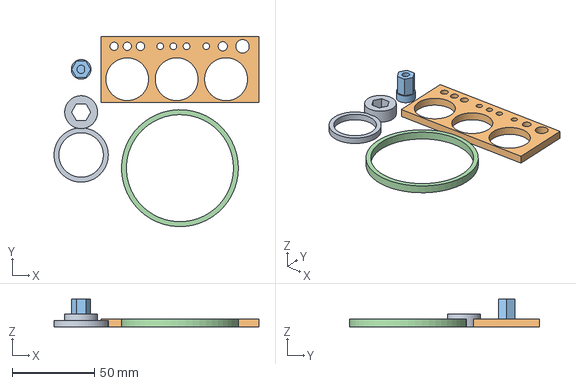
[picture p50: CAD file, 2026-09-22]
designs/04-cyc30-d80-v2/step/fit_coupon.step
124.5 x 115.5 x 17.0 mm
