TaylorAndonian/cycloidal-drive/designs/02-cyc50-d100/cad/carrier_rear_plate.step

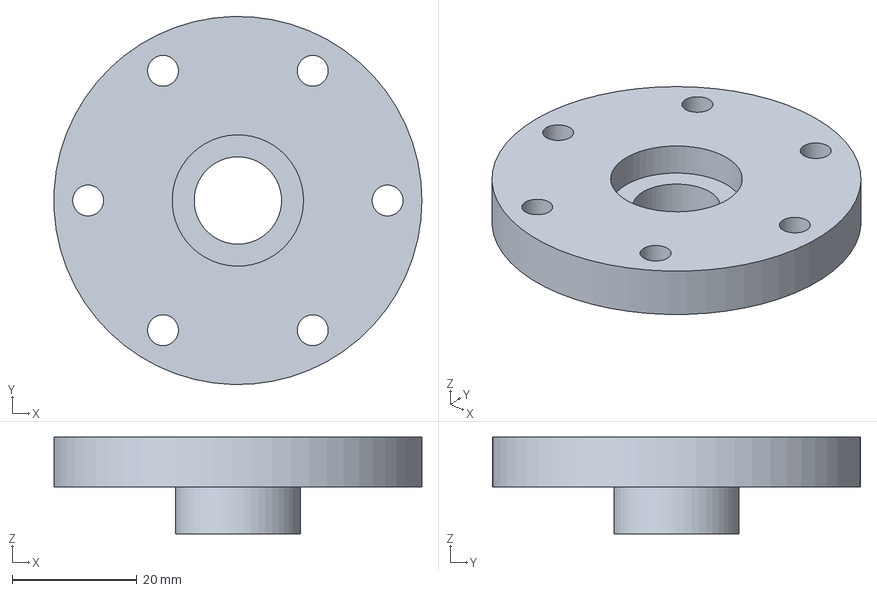
[picture p51: CAD file, 2026-09-05]
designs/02-cyc50-d100/cad/carrier_rear_plate.step
59.0 x 59.0 x 15.5 mm
