TaylorAndonian/cycloidal-drive/designs/03-cyc30-d80-v1/step/carrier.step

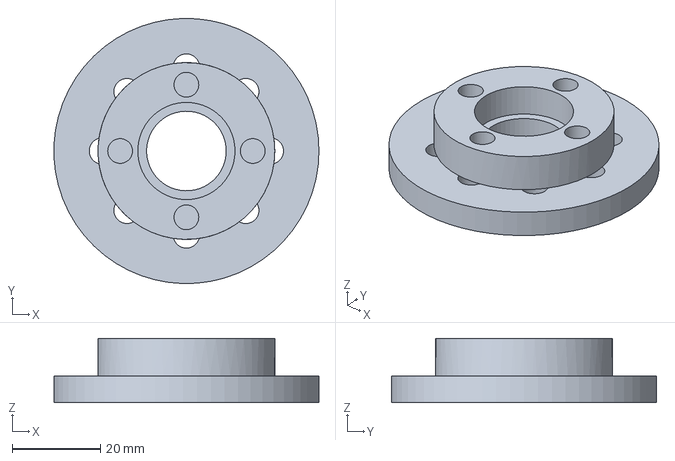
[picture p52: CAD file, 2026-09-16]
designs/03-cyc30-d80-v1/step/carrier.step
60.0 x 60.0 x 14.5 mm
