TaylorAndonian/cycloidal-drive/designs/04-cyc30-d80-v2/step/output_cap.step

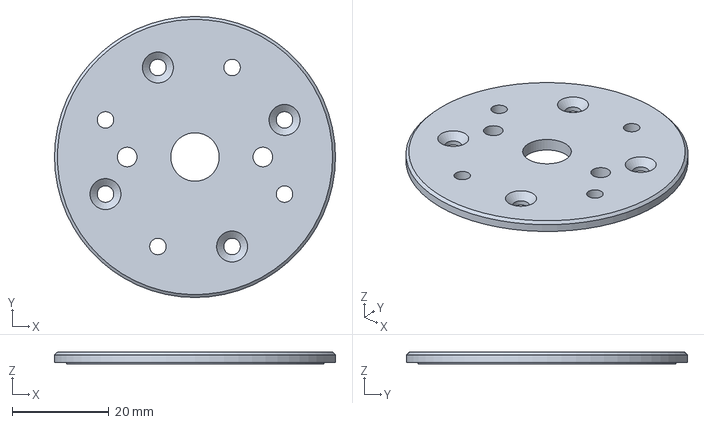
[picture p53: CAD file, 2026-09-22]
designs/04-cyc30-d80-v2/step/output_cap.step
58.0 x 58.0 x 2.50 mm
