TaylorAndonian/cycloidal-drive/designs/02-cyc50-d100/cad/output_flange.step

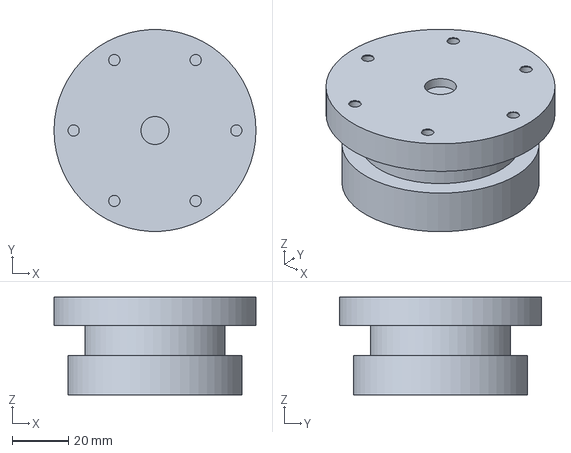
[picture p54: CAD file, 2026-09-05]
designs/02-cyc50-d100/cad/output_flange.step
72.0 x 71.9 x 34.8 mm
