TaylorAndonian/cycloidal-drive/designs/04-cyc30-d80-v2/step/front_retainer.step

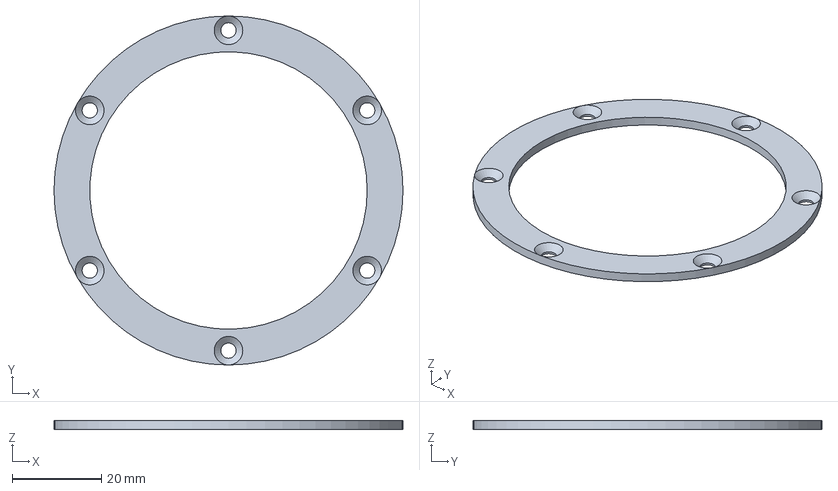
[picture p55: CAD file, 2026-09-22]
designs/04-cyc30-d80-v2/step/front_retainer.step
78.0 x 78.0 x 2.00 mm
