TaylorAndonian/cycloidal-drive/designs/05-cyc30-d80-v3/step/cam_b.step

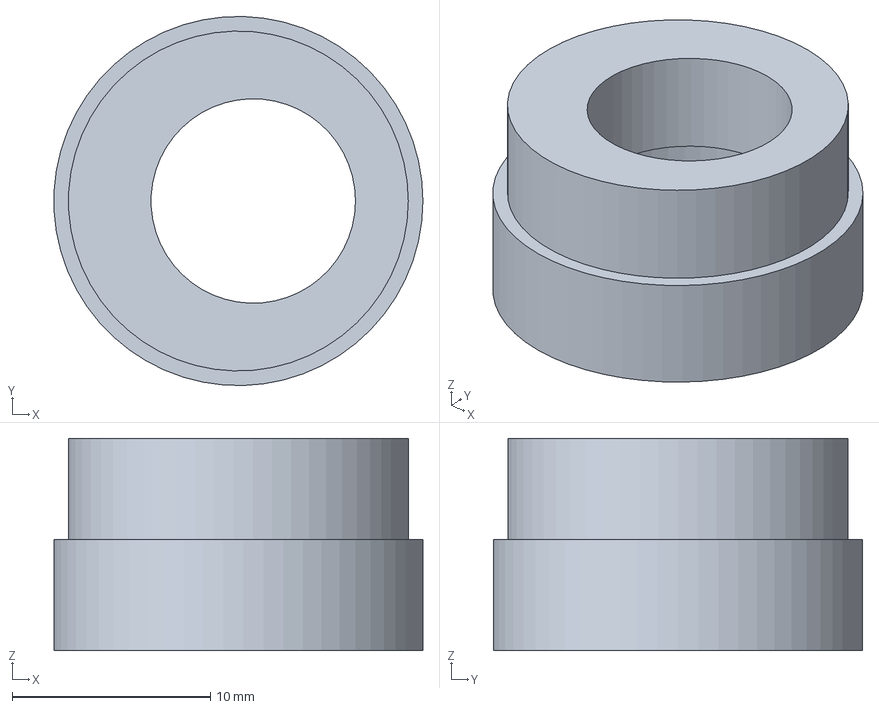
[picture p56: CAD file, 2026-10-01]
designs/05-cyc30-d80-v3/step/cam_b.step
18.6 x 18.6 x 10.7 mm
