TaylorAndonian/cycloidal-drive/designs/02-cyc50-d100/cad/rear_cup.step

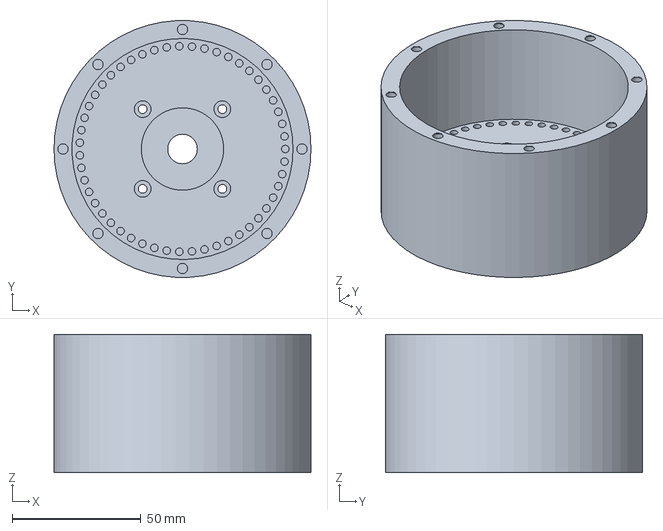
[picture p57: CAD file, 2026-09-05]
designs/02-cyc50-d100/cad/rear_cup.step
100.0 x 99.9 x 53.8 mm
