TaylorAndonian/cycloidal-drive/designs/05-cyc30-d80-v3/step/disc.step

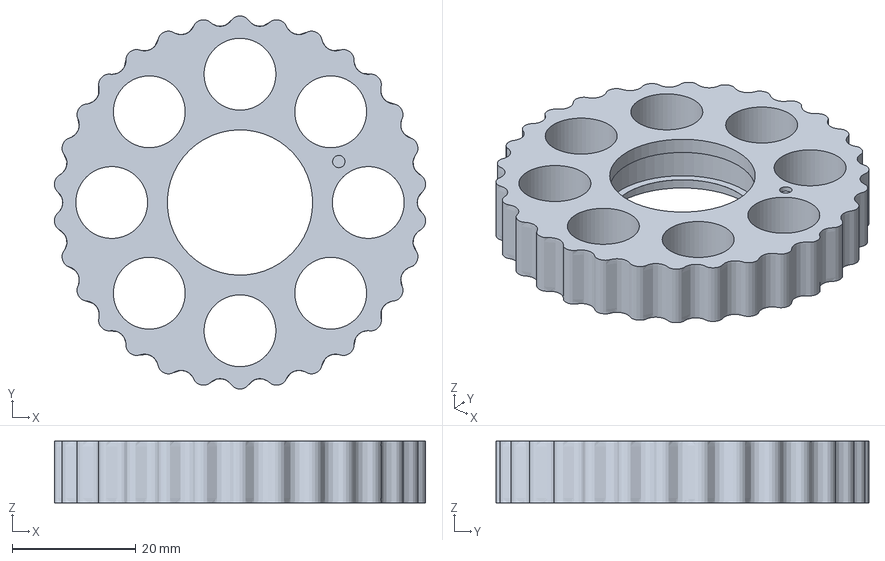
[picture p58: CAD file, 2026-10-01]
designs/05-cyc30-d80-v3/step/disc.step
60.0 x 60.3 x 10.0 mm
