TaylorAndonian/cycloidal-drive/designs/04-cyc30-d80-v2/step/shaft_spacer.step

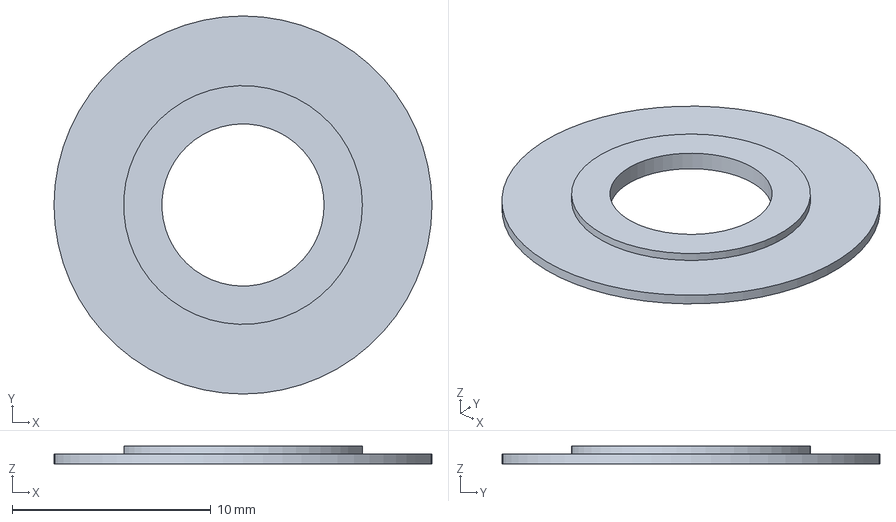
[picture p59: CAD file, 2026-09-22]
designs/04-cyc30-d80-v2/step/shaft_spacer.step
19.0 x 19.0 x 0.9 mm
