TaylorAndonian/cycloidal-drive/designs/04-cyc30-d80-v2/step/output_flange.step

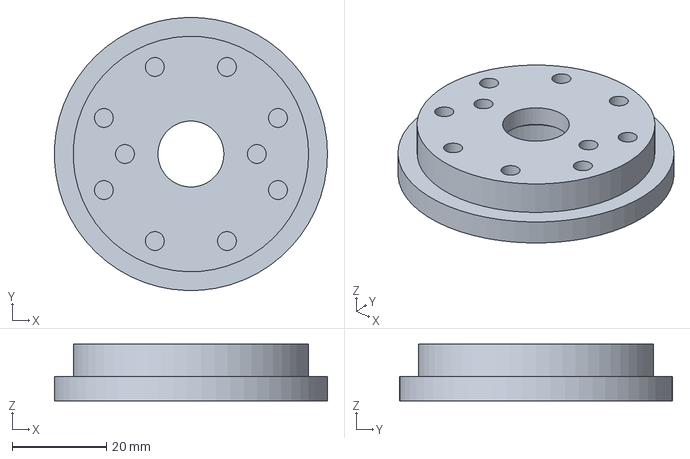
[picture p60: CAD file, 2026-09-22]
designs/04-cyc30-d80-v2/step/output_flange.step
58.0 x 58.0 x 12.0 mm
