TaylorAndonian/cycloidal-drive/(list of files, cad)

Other CAD files:
designs/05-cyc30-d80-v3/step/ASSEMBLY_cycloidal_30_d80_v3.step
designs/03-cyc30-d80-v1/step/disc_a.step
designs/05-cyc30-d80-v3/step/back_plate.step
designs/04-cyc30-d80-v2/step/disc.step
designs/05-cyc30-d80-v3/step/roller_sleeve_3.9.step
designs/05-cyc30-d80-v3/step/output_cap.step
designs/04-cyc30-d80-v2/step/housing.step
designs/05-cyc30-d80-v3/step/front_retainer.step
designs/01-cyc50-d138/cad/assembly.3mf
designs/01-cyc50-d138/cad/carrier_rear_plate.step
designs/01-cyc50-d138/cad/carrier_rear_plate.stl
designs/01-cyc50-d138/cad/coupon_bearings.step
designs/01-cyc50-d138/cad/coupon_pins_inserts.step
designs/01-cyc50-d138/cad/disc.step
designs/01-cyc50-d138/cad/disc.stl
designs/01-cyc50-d138/cad/eccentric_shaft.step
designs/01-cyc50-d138/cad/eccentric_shaft.stl
designs/01-cyc50-d138/cad/front_plate.step
designs/01-cyc50-d138/cad/front_plate.stl
designs/01-cyc50-d138/cad/output_flange.step
designs/01-cyc50-d138/cad/output_flange.stl
designs/01-cyc50-d138/cad/rear_cup.step
designs/01-cyc50-d138/cad/rear_cup.stl
designs/01-cyc50-d138/cad/washer_end.step
designs/01-cyc50-d138/cad/washer_end.stl
designs/01-cyc50-d138/cad/washer_mid.step
designs/01-cyc50-d138/cad/washer_mid.stl
designs/02-cyc50-d100/cad/carrier_rear_plate.stl
designs/02-cyc50-d100/cad/coupon_bearings.stl
designs/02-cyc50-d100/cad/coupon_pins_inserts.stl
designs/02-cyc50-d100/cad/coupon_shaft.stl
designs/02-cyc50-d100/cad/disc v1.f3d
designs/02-cyc50-d100/cad/disc.step
designs/02-cyc50-d100/cad/disc.stl
designs/02-cyc50-d100/cad/eccentric_shaft.stl
designs/02-cyc50-d100/cad/front_plate.stl
designs/02-cyc50-d100/cad/mid_pin_ring.stl
designs/02-cyc50-d100/cad/output_flange.stl
designs/02-cyc50-d100/cad/rear_cup.stl
designs/02-cyc50-d100/cad/washer_end.step
designs/02-cyc50-d100/cad/washer_end.stl
designs/02-cyc50-d100/cad/washer_mid.step
designs/02-cyc50-d100/cad/washer_mid.stl
designs/03-cyc30-d80-v1/stl/carrier.stl
designs/03-cyc30-d80-v1/stl/coupon.stl
designs/03-cyc30-d80-v1/stl/disc_a.stl
designs/03-cyc30-d80-v1/stl/disc_b.stl
designs/03-cyc30-d80-v1/stl/face_plate.stl
designs/03-cyc30-d80-v1/stl/motor_plate.stl
designs/03-cyc30-d80-v1/stl/ring_plate.stl
designs/03-cyc30-d80-v1/stl/shaft.stl
designs/03-cyc30-d80-v1/stl/sleeve.stl
designs/04-cyc30-d80-v2/step/cam.3mf
designs/04-cyc30-d80-v2/step/shaft_spacer.3mf
