TaylorAndonian/cycloidal-drive/designs/02-cyc50-d100/assembly-guide.html

Build card · cycloidal-50-d100 · rev A

# 50:1 Cycloidal Reducer

Bench assembly for the Ø100 arm-drive build. Every dimension here is read from cad/layout.json and the parameters block in scripts/cad.py — if you change a parameter and re-run, re-read these numbers.

EnvelopeØ100 × 88.1 mm

Rated torque18 Nm continuous

Ring51 × Ø3 pins on Ø80

Discs2 × 14 mm, 180°

Build time~2 hours + printing

0 / 0 steps ticked Clear all ticks

## Before you touch a part

gate 0

Two things decide whether this build works, and both happen before assembly: the press fits, and the disc material. Get them wrong and no amount of careful assembly saves it.

### Print check

1. Both discs printed in PA-CF, 100 % infill, 6 walls, 0.16 mm layers. PC yields at 18 Nm — exactly the rated torque, so PC discs give zero margin.
2. Rear cup and front plate in PA-CF (PC acceptable, −40 % stiffness). These two plates are the entire anti-skip argument.
3. Eccentric shaft in PC, printed vertically on its Ø12 end, 0.12 mm layers, 100 % infill. The 45° cones under the steps are modelled — no supports.
4. Filament was dried. Wet PA-CF loses a third of its strength and these parts are all press fits.
5. Discs measured across the lobe tips: 79.16 mm ±0.15. Out by more than that and the profile clearance is wrong.

### Coupon calibration

Print coupon_pins_inserts.stl in the cup / front-plate material and profile, and coupon_bearings.stl in the disc / flange material. Same nozzle, same speeds, same layer height as the real parts.

1. Try a Ø3 dowel in each hole of the Ø3 row. Pick the one that takes the pin with a firm arbor-press push and no cracking.
2. If that hole is not 2.95, shift FIT_PIN_PRESS_REAR by the difference and re-run cad.py.
3. Same for the Ø8 row → FIT_OUTPIN_PRESS, and the bearing pockets → FIT_BRG_OD_IN_PLASTIC.
4. Melt an insert into each of the four insert holes. The right one goes in square, raises a small bead of plastic, and strips its thread before it pulls out.

Do not skip this

A loose front-plate pin hole turns a pin supported at both ends into a cantilever. That single change is most of the difference between this design and the one that skips.

### Tools

Arbor press or a vice with soft jaws · 2.5 mm hex key (ball end helps) · soldering iron with an insert tip, 220–240 °C · dial indicator + stand or V-blocks · calipers · small square · PTFE or lithium grease · deburring tool.

## What goes where

reference

Lay these out before you start. Positions are millimetres from the motor mounting face, which is z = 0 throughout this card and in the drawings.

Bearing | Size | Qty | Where | Sits at z | Fit
6801-2RS | 12×21×5 | 1 | Input shaft rear journal, in the carrier plate | 18.5 – 23.5 | OD press in plastic
6804-2RS | 20×32×7 | 1 | Carrier rear support, in the cup floor | 7.7 – 14.7 | OD press / ID on boss
6802-2RS | 15×24×5 | 2 | Eccentric bearings, one per cam | 28.4 – 33.4 · 43.4 – 48.4 | ID press on cam, OD press in disc
625ZZ | 5×16×5 | 24 | Output rollers — four per pin, in two pairs | 25.9 – 35.9 · 40.9 – 50.9 | slip on pin
608ZZ | 8×22×7 | 1 | Input shaft front journal, in the flange | 53.3 – 60.3 | OD press in plastic
6810-2RS | 50×65×7 | 1 | Output bearing, flange boss to front plate | 67.3 – 74.3 | ID press on boss, OD press in plate

Fastener / pin | Size | Qty | Where | Depth / note
Ring pin | Ø3 × 60 | 51 | Cup floor → front plate | 8.0 in cup, 13.2 in plate
Output pin | Ø5 × 50 | 6 | Carrier plate → flange | 8.0 through carrier, 12.2 in flange
Heat-set insert | M3, Ø4.0 × 5.7 | 18 | 8 shell top · 6 flange face · 4 cup back | hole Ø4.0 × 9.0 deep
SHCS, motor | M3 × 6 or 8 | 4 | Through the cup floor into the motor | see step 1 — measure first
SHCS, tie bolts | M3 × 30 | 8 | Front plate → shell inserts | 22.8 through + 7.2 engaged
SHCS, arm | M3 × (root + 5) | 6 | Arm → flange face, Ø58 PCD | Ø10 pilot takes the shear

## Assembly

8 steps

Each drawing is the real CAD cross-section on the plane through the eccentric. The part you are fitting is drawn solid and dark; everything already fitted is faded; everything still to come is a dotted ghost.

1

### Rear cup: inserts, motor, carrier bearing

Order matters here. The motor screw heads live in counterbores that the 6804 pocket sits directly above — once that bearing is in, you cannot reach them.

1. Deburr every printed hole. Run a Ø3 drill bit by hand through the 51 pin holes to clear elephant-foot from the first layer.
2. Melt in 8 inserts in the shell top face (Ø93 PCD) and 4 inserts in the cup's back face (Ø90 PCD, these mount the gearbox to your machine).
3. Measure your motor's thread depth with a depth gauge or a scrap screw. Screw length = 2.5 + engagement. Most NEMA 17s are 4.5 mm deep, so M3×6 (3.5 mm engaged) is the safe pick; use M3×8 only if you measure ≥6 mm.
4. Seat the motor's Ø22 pilot boss in the recess on the back of the cup. It should drop in with a slip fit — there is 0.3 mm of clearance.
5. Run the 4 motor screws in from inside the cup, straight down through the counterbores. Snug, then a quarter turn — you are clamping printed plastic, not steel.
6. Press the 6804 into its Ø32 pocket. It bottoms at z 7.7 and stands 0.3 mm below the floor face — that gap is intentional axial float.
7. That is the only bearing in the cup. The 6801 does not go here — it lives in the carrier plate and is fitted in step 3.

Press bearings with a flat plate across the whole outer race, never on the inner race — pushing through the balls brinells the raceway and you will feel it as notchiness forever.

Step 1 — cup with the motor mounted and the carrier bearing seated in the floor.

2

### Press the 51 ring pins

This is the longest and most tedious step, and the one that most repays care. These pins are the fixed ring — every one of them has to end up parallel to the axis.

1. Chamfer the leading end of each pin lightly if the dowels came square-cut.
2. Press each Ø3×60 pin into the floor until it bottoms at 8 mm. It then stands 52 mm proud of the floor face.
3. Use a drill-press chuck (jaws open, quill as the ram) or an arbor press with a flat pusher. Keep the pin square going in — Ø3 bends far more easily than Ø4.
4. Every fifth pin, check with a small square against the floor face.
5. Measure the free ends: lay a straightedge across and confirm all 51 tips sit within about 0.5 mm of one plane.

Go / no-go — pin squareness

A pin leaning 1° is 0.7 mm out of place by the time it reaches the front plate. The front plate holes are a light press with 0.02 mm of interference — they will not pull a bent pin straight, they will jam.

If a pin is visibly off: pull it, check the hole for a blob or a lifted first layer, and press a fresh pin. Pulling and re-pressing the same hole twice loses the interference — if a hole ends up loose, reprint the cup.

Step 2 — only one pin lies on the section plane; the other 50 are around the Ø80 circle.

3

### Build the input shaft and carrier — and check the indexing

The 180° between the two cams is printed in, not set at assembly. What you are checking is whether the print came out round and on-centre.

1. Press the cam-A 6802 on from the rear, over the Ø12 journal, until it butts on the Ø17 collar. Cam A is the one offset toward +x.
2. Press the cam-B 6802 on from the front, over the Ø8 journal, until it butts on the other side of the collar.
3. Push on the inner races only. The journals are printed — go slowly and keep them square, and stop if you hear crazing.

Go / no-go — eccentric indexing

Support the shaft in V-blocks (or spin it in the 6801 in the cup) and run a dial indicator on each 6802's outer race in turn:

• Total runout on each: 1.18 mm TIR (that is 2e).
• The two peaks 180° apart within 3°. Even 3° only moves a disc centre by 0.03 mm.
• The two amplitudes matching within 0.05 mm. A difference here shifts torque onto whichever disc has the larger throw.

Fail any of these and reprint the shaft. Everything downstream assumes it.

1. Runout on both cams reads 1.18 mm, peaks 180° apart, amplitudes matched.
2. Press the 6801 into the carrier plate, into the Ø21 pocket in its front face. It bottoms on a 3 mm floor at z 18.5 and finishes flush with the front face.
3. Press the six Ø5×50 output pins into the carrier plate until flush with its rear face. Do this now, off the machine — not later, when pressing would push against the 6804.
4. Onto each output pin: a 2.4 mm washer, then two 625ZZ. Grease the pins lightly first.
5. Slide the carrier onto the shaft from the REAR end. Its Ø14 boss bore clears the Ø12 journal but not the Ø15 cams — it only goes on from that side, and there is no way to add it later. The 6801 presses onto the Ø12 journal as it goes.
6. Lower the whole sub-assembly into the cup: D-bore over the motor shaft, carrier boss press into the 6804.

The D-bore is 12.5 mm deep and takes the motor shaft from z 10.0. With a 22 mm usable shaft you get full engagement. Longer or shorter shaft: change MOTOR_SHAFT_L and re-run — check_layout will refuse anything under 8 mm of engagement.

Step 3 — shaft, both cam bearings, the 6801 in the carrier plate, seated in the cup. Both shaft journals are carried by the carrier; the carrier is grounded on the 6804 and, later, the 6810.

4

### The output pin stack

Four 625s per pin, not two. A single 5 mm roller in a 14 mm disc hole would carry the load on a third of the width; two side by side cover 10 mm of it.

The full stack on each of the six pins, rear to front — it adds up to exactly the 29.8 mm between the carrier face and the flange:

Order | Item | Thickness
1 | printed washer (short) | 2.4
2–3 | 625ZZ ×2 — disc A rides here | 10.0
4 | printed washer (long) | 5.0
5–6 | 625ZZ ×2 — disc B rides here | 10.0
7 | printed washer (short) | 2.4

1. Confirm the first washer + two rollers are already on each pin from step 3.
2. Check the washers spin free — they bear on the roller inner races only, so their OD must stay clear of the outer race.
3. Spin each roller pair by hand. Any that feels gritty, swap it now.

The drawing shows the finished stack. You build it in three bites: pair A now, the long washer and pair B after disc A goes on, the last washer after disc B.

Step 4 — the completed pin stack. Washers are the thin violet slivers between roller pairs.

5

### Disc A

The disc goes onto its cam bearing and over the first roller pair in one axial movement. Both discs are identical parts and both go on the same way round.

1. Identify the disc's counterbored face — one side has a Ø24 pocket, the other a plain Ø22 hole. The counterbore faces forward, toward the output.
2. Grease the lobe flanks. A PTFE or lithium film; dry running costs 10–15 % efficiency and all of it becomes heat in the lobes.
3. Line the six roller holes up with the six roller pairs and lower the disc, guiding it onto cam A's bearing at the same time.
4. Press the disc down until the 6802 seats on the internal ledge — the bearing ends up centred in the disc's 14 mm thickness.
5. Turn the motor shaft by hand through two full turns. Disc A should walk around the pins with no tight spot.

If it binds here

A tight spot that moves with the shaft is cam runout. One that stays with the housing is a leaning ring pin — find it and fix it now, because after the front plate goes on you cannot.

Uniformly stiff all the way round is profile clearance. Measure the printed pin circle with pins in place and the disc across its lobe tips before you touch PROFILE_CLR — it is usually the print, not the parameter.

Step 5 — disc A on cam A. Its centre sits +0.59 mm off axis.

6

### Disc B, half a lobe out of phase

Disc B sits on the opposite cam so its radial load cancels disc A's. The phase is not something you set by eye — the roller holes only line up in the right one.

1. Add the 5.0 mm washer then two more 625ZZ to each of the six pins.
2. Take the second disc, counterbore forward again, and rotate it 3.6° (180°/50) relative to disc A — one half lobe.
3. Lower it over the second roller pair and onto cam B's bearing. Do not force the phase — with the rollers already on the pins the disc only drops on in the correct one. If it will not sit, rotate it one hole position and try again.
4. Press until the 6802 seats on its ledge.
5. Add the last 2.4 mm washer to each pin. The stack should now sit flush with the pin ends within a few tenths.
6. Turn the input again. It should feel noticeably smoother than with one disc — that is the radial forces cancelling.

Sanity check by eye: looking down the axis, any lobe tip of disc B should sit opposite a lobe root of disc A across the centre.

Step 6 — disc B at −0.59 mm, disc A faded behind it.

7

### Output flange and its two bearings

The flange plus the carrier plate form a rigid cage around both discs, carried on two bearings 60 mm apart. That span is what resists the arm's moment.

1. Melt 6 inserts into the flange face plate (Ø58 PCD) if you have not already.
2. Press the 608 into the pocket in the flange's rear face.
3. Bring the flange down onto the six output pin ends — 12.2 mm of engagement into 12.5 mm blind holes — with the 608 passing over the shaft's Ø8 front journal at the same time.
4. Press evenly, alternating around the six pins. Six simultaneous press fits need real force; if it stops moving, back off and check for a cocked pin rather than pushing harder.
5. Press the 6810 onto the flange's Ø50 boss, inner race first, until it seats against the shoulder.
6. Turn the input once more. The flange should now rotate as one with the carrier.

Step 7 — flange, front journal bearing and the 6810 that carries the arm load.

8

### Front plate closes the ring

Fifty-one light press fits and one bearing, all engaging together. Let the eight tie bolts do the work — they are designed to draw the plate down.

1. Offer the plate up so that all 51 pin tips start in their holes and the 6810 starts in its bore at the same time. Get it sitting square before applying any force.
2. Start all eight M3×30 bolts by hand into the shell inserts.
3. Draw the plate down in quarter turns, star pattern, going round several times. Never pull one corner down alone.
4. There are no counterbores at this diameter — the heads sit on the front face, clear of the Ø72 arm plate.
5. Stop tightening when the plate is fully seated against the shell. You are clamping printed plastic.

If it will not go down

Do not force it. One pin is bent or leaning. Back the bolts off, lift the plate, and find the pin whose tip is out of position — a straightedge across the pin ends will show it.

Go / no-go — finished drive

• Two full turns of the input feel uniform, with no periodic tight spot.
• Backlash at the output is roughly 0.3–0.4°. Much more means the profile clearance is too generous.
• Free-running current on your driver at low speed is no more than about 15 % above the bare motor.

Step 8 — complete. Overall length 88.1 mm from motor face to arm face.

## Run-in, then the arm

commissioning

1. Run it unloaded for 20–30 minutes at moderate speed, both directions. The first hours are when the printed lobes bed in.
2. Stop and feel the housing. Warm is fine; too hot to hold means something is binding, not bedding in.
3. Re-check backlash after run-in. A small increase is normal bedding; a large one means the lobes are yielding — back the torque off.
4. Bolt the gearbox to the machine through the 4 inserts in the cup's back face, never through the front plate.
5. Fit the arm: Ø10 spigot into the pilot bore first, then the 6 M3 on the Ø58 circle. The pilot carries the shear, the bolts carry the moment.
6. Record the arm tip height at a known pose. Re-measure monthly — that is how you catch flange creep before it becomes a problem.

Torque budget

Rated 18 Nm continuous. Lobe contact stress reaches PA-CF yield at about 30 Nm, so keep peaks under ~24 Nm.

A NEMA 17 at 0.45 Nm delivers roughly 19 Nm through this at 85 % efficiency, so the motor is effectively the fuse. The way to overload it is to back-drive the arm into something — that path bypasses the motor entirely.

Orientation note: with the arm horizontal, gravity loads the same side of the ring continuously and that side wears first. If the arm has a home position, vary it. The pin circle is symmetric, so rotating the front plate 180° later gives you a fresh side.

## If something is wrong

diagnosis

Symptom | Most likely cause | What to do
Periodic tight spot, once per input revolution | Cam runout, or a 6802 pressed on crooked | Strip to step 3 and re-run the indexing check. Reprint the shaft in PC if runout is off.
Tight spot at a fixed housing position | A leaning or bent ring pin | Straightedge across the pin ends to find it. Replace the pin; reprint the cup if the hole has gone loose.
Uniformly stiff, warms quickly at no load | Profile clearance too small, or the printed pin circle is undersize | Measure first, then raise PROFILE_CLR by 0.03 at a time and reprint the discs.
Backlash grows over hours of use | Lobe flanks creeping — running above ~24 Nm, or dry | Re-grease, cap peak torque. If it persists, the fix is machined POM or nylon discs, not thicker printed ones.
Clunk on load reversal | Bedded-in flanks plus the normal 0.10 mm profile clearance | Expected at some level. If it grows, treat as the row above.
It skips under load | Almost certainly a loose front-plate pin seat | The model says skip needs >300 Nm with both ends supported. If it skips at working torque, a pin is not held at both ends. Check the front plate holes against the coupon.
Arm droops a fraction of a degree and stays there | Printed flange body creeping under the constant moment | Reprint the flange in PA-CF at higher infill, or shorten the reach. Bearings are not the issue — the load is 2.6 % of the 6810's rating.
Notchy, gritty rotation from new | A bearing brinelled during pressing | Find it by feel and replace it. Always press on the race you are fitting, never through the balls.

cycloidal-50-d100 · rev A. Numbers generated from scripts/cad.py and cad/layout.json; drawings are true cross-sections of the exported STEP geometry, produced by scripts/render_steps.py. Full project, including the analysis behind the torque rating, is in Downloads\cycloidal-50-d100.

Ticks are saved into this page, so you can close it and come back mid-build.
