TaylorAndonian/cycloidal-drive/designs/02-cyc50-d100/renders/assembly_section.png

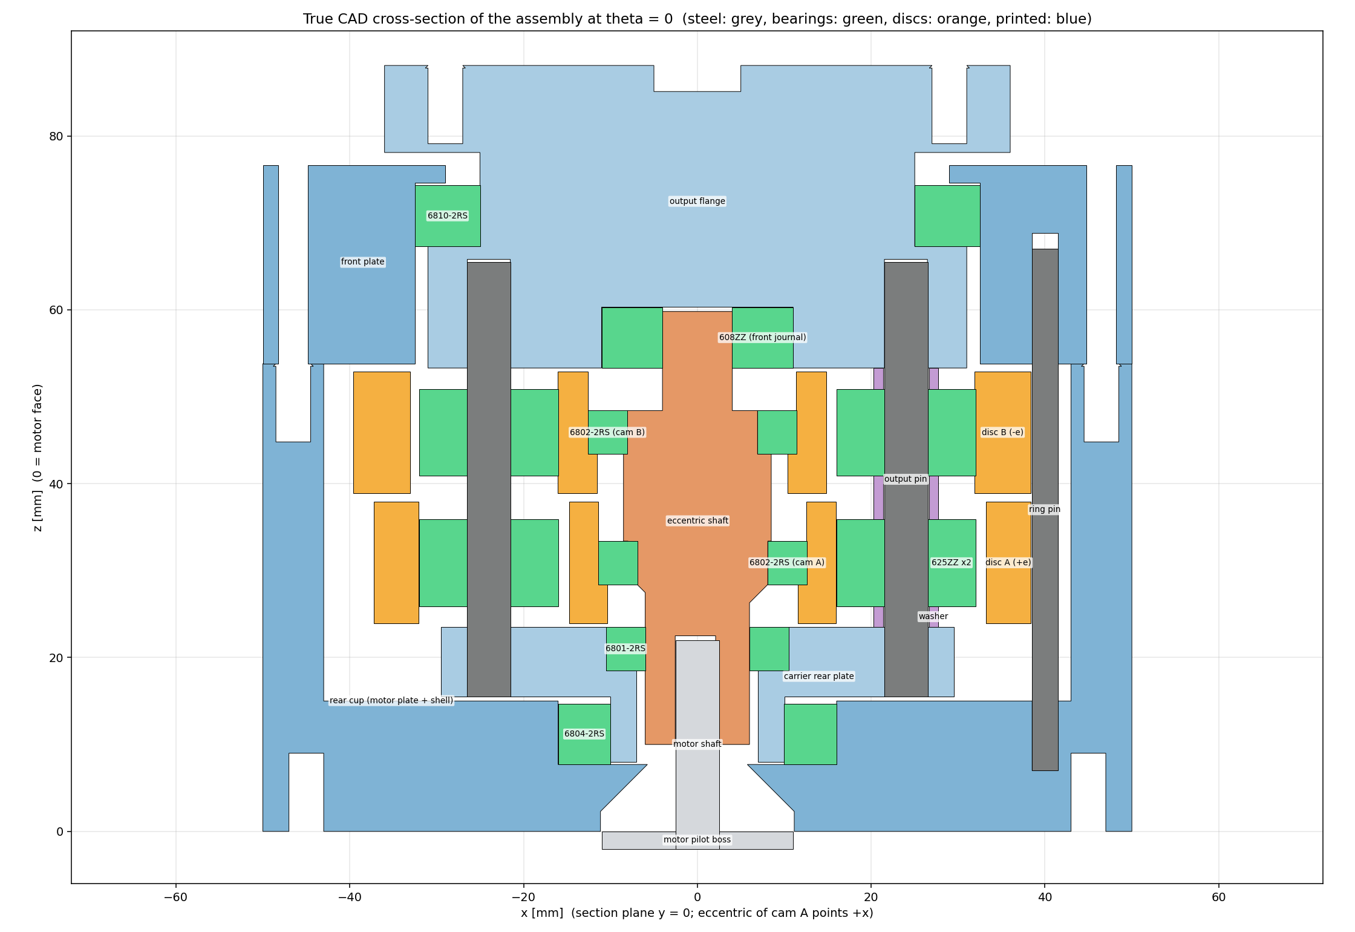
designs/02-cyc50-d100/renders/assembly_section.png
