TaylorAndonian/cycloidal-drive/designs/02-cyc50-d100/renders/step_2.png

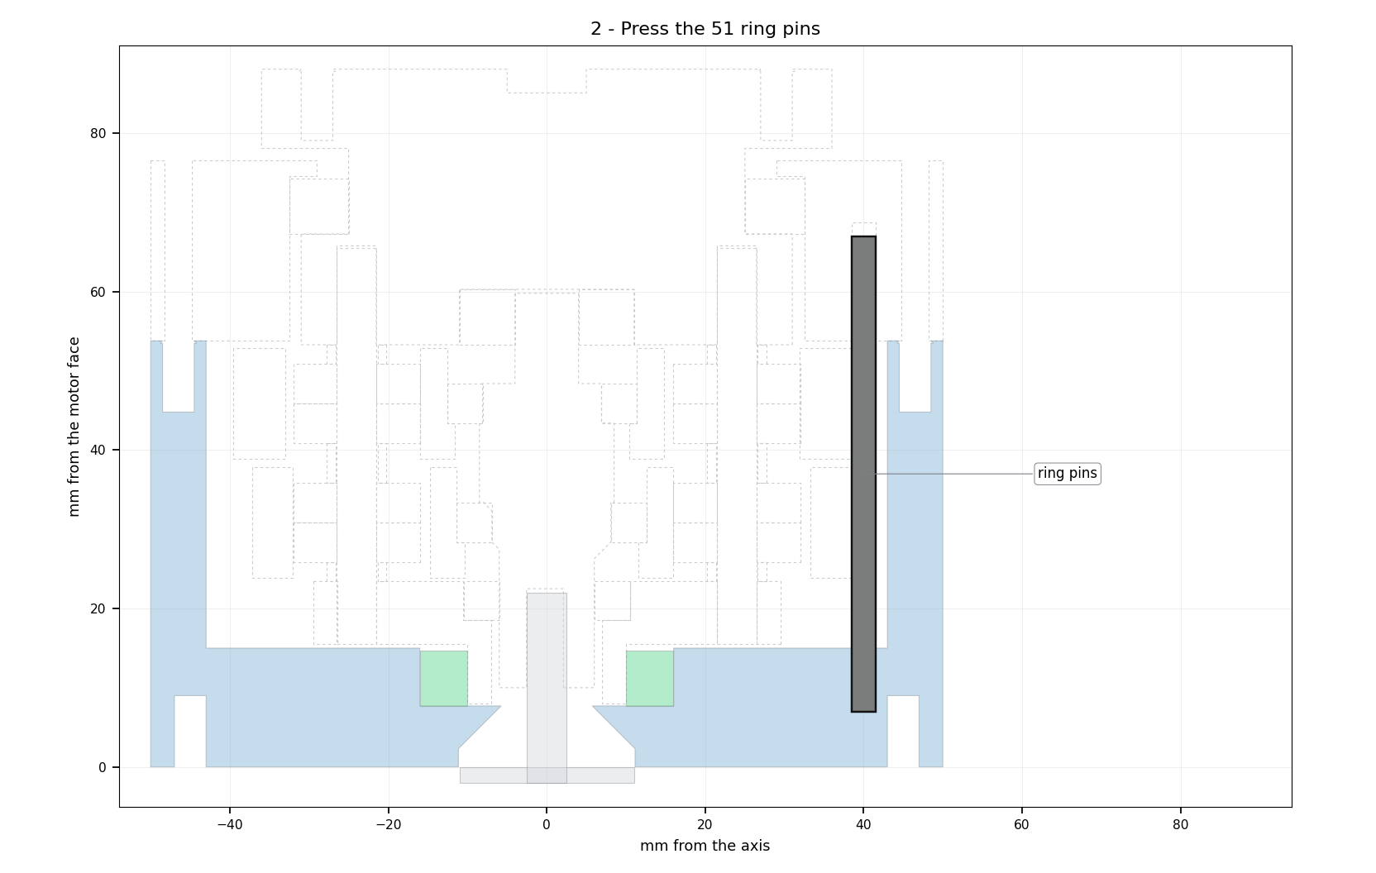
designs/02-cyc50-d100/renders/step_2.png
