TaylorAndonian/cycloidal-drive/designs/04-cyc30-d80-v2/render_assembly.png

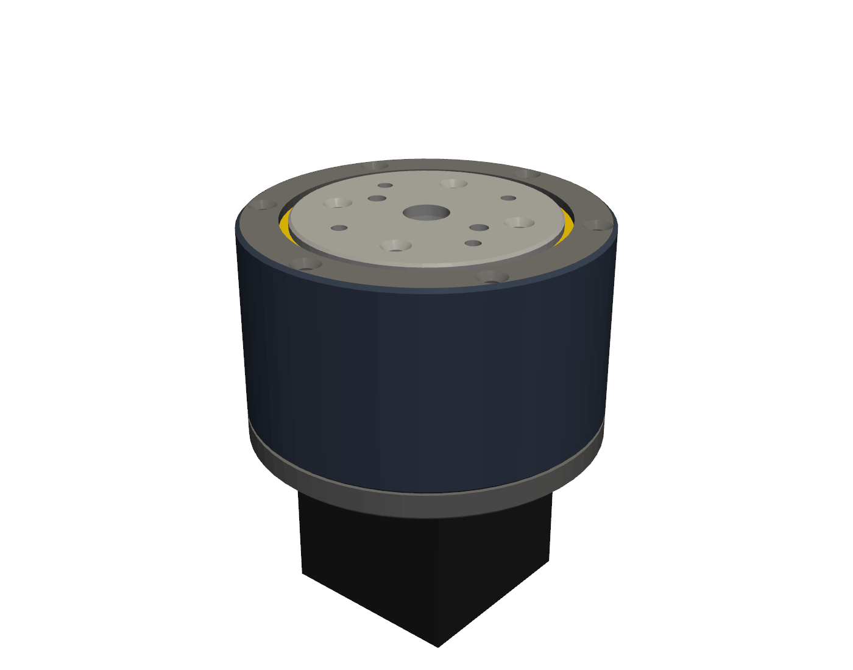
designs/04-cyc30-d80-v2/render_assembly.png
