TaylorAndonian/cycloidal-drive/(commit log)

2026-09-05 Add 50:1 cycloidal drive for NEMA 17 (Ø138)
    51 ring pins / 50 lobes, two discs at 180°. Parametric build123d model,
    disc-profile math, Hertz/skip analysis and 39 geometry checks on the
    exported STEP.
    Claude-Session: https://claude.ai/code/session_01GsD4LDQ6RVMtLcUMLutnvi
    [BOM.csv, assembly.3mf, assembly.step, carrier_rear_plate.step, carrier_rear_plate.stl, coupon_bearings.step, coupon_bearings.stl, coupon_pins_inserts.step]
2026-09-05 Add Ø100 variant of the 50:1 drive for the arm X axis
    Pin circle Ø112 -> Ø80, so contact stress rises ~40% and the rating drops
    to 18 Nm. Output rollers 608 -> 2x 625ZZ per pin, new bearing set,
    step-by-step assembly guide.
    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
    [BOM.csv, assembly.step, carrier_rear_plate.step, carrier_rear_plate.stl, coupon_bearings.step, coupon_bearings.stl, coupon_pins_inserts.step, coupon_pins_inserts.stl]
2026-09-08 Ø100: model disc v1 in Fusion 360
    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
    [disc v1.f3d, disc v1.step]
2026-09-10 Ø100: rework eccentric shaft and add a shaft fit coupon
    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
    [coupon_shaft.step, coupon_shaft.stl, eccentric_shaft.step, eccentric_shaft.stl]
2026-09-16 Add 30:1 Ø80 small-joint drive (v1)
    31 pins / 30 lobes, eccentric shaft supported at both ends and all pins
    captured in both plates: the fix for the original prototype skipping
    under load (ring spreading, eccentric deflecting).
    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
    [BOM-d80.csv, assembly.step, carrier.step, carrier.stl, coupon.step, coupon.stl, disc_a.step, disc_a.stl]
2026-09-22 v2: full revision of the 30:1 joint
    Hex input shaft so the cams can be assembled, 608 nose bearing,
    shoulder-bolt output pins with MR105 rollers held at both ends,
    6810 + 6704 output bearings, ring pins in a solid one-piece housing.
    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
    [ASSEMBLY_cycloidal_30_d80_v2.step, BOM.csv, disc.step, fit_coupon.step, front_retainer.step, housing.step, output_cap.step, output_flange.step]
2026-09-23 v2: edit cycloid disc (C DISK)
    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
    [C DISK.step]
2026-09-26 v2: add input shaft
    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
    [input_shaft.step]
2026-09-29 v2: add cam
    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
    [cam.step]
2026-09-30 v2: add back plate
    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
    [back_plate.step]
2026-09-30 v2: add sliced print file for the shaft spacer
    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
    [shaft_spacer.3mf]
2026-10-01 v3: fix stiffness and the broken shaft from v2
    v2 bound up: almost no profile clearance, zero-backlash output holes,
    bearings pressed hard enough to squeeze the disc bore oval. v3 adds
    mesh/output clearance, floating 608 and 6704 seats, +0.125 mm on printed
    ODs (measured on the v2 prints), and a one-piece Ø14 shaft with cam A
    built in, replacing the hex shaft that snapped.
    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
    [ASSEMBLY_cycloidal_30_d80_v3.step, back_plate.step, cam_b.step, disc.step, front_retainer.step, input_shaft.step, output_cap.step, roller_sleeve_3.6.step]
2026-10-01 v2: add sliced print file for the cam
    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
    [cam.3mf]
2026-10-02 v3: update rear ring and output flange
    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
    [output_flange.step, rear_ring.step]
2026-10-02 v3.1: tighten ring-pin clearance 0.15 -> 0.09 mm
    Pins rattled in the grooves at 0.15. Regenerated housing and fit coupon.
    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
    [fit_coupon.step, housing.step]
2026-10-05 Add belt-drive conversion for the 30:1 joint
    Motor moves beside the gearbox on a 1:1 2GT belt (180 mm, 70 mm centres),
    input shaft runs in two 608s in a rear tower. Saves ~16 mm of height and
    moves the motor mass off the back of the joint.
    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
    [ASSEMBLY_belt_drive.step, back_plate_belt.step, idler_standoff.step, input_shaft_belt.step, motor_bracket.step, tower_bearing_spacer.step]
